dangthanhson2kk4-dotcom/Openlane_SERV_OPT/runs/Routing/reports/routing/23-wire_lengths.csv

net | length_um
_0539_ | 359.16
clknet_0_clk | 308.57
_0515_ | 307.67
_0203_ | 288.87
_0189_ | 285.43
net72 | 272.05
_0579_ | 256.38
_0590_ | 253.63
_0252_ | 248.465
_0572_ | 247.97
net79 | 245.08
net136 | 241.63
net116 | 236.48
net93 | 234.32
_0448_ | 221.24
net112 | 221.14
_0453_ | 218.17
net141 | 211.04
net148 | 209.22
net105 | 206.74
net91 | 206.14
net83 | 199.21
net122 | 198.1
net159 | 192.8
_0420_ | 190.28
_0397_ | 189.08
net34 | 188.5
net166 | 185.37
net107 | 183.365
net157 | 183.14
net89 | 179.84
net67 | 173.42
net119 | 170.88
net75 | 167.38
net149 | 167.38
clk | 165
net146 | 164.46
_0522_ | 163.71
net164 | 161.2
net22 | 159.63
net98 | 159.32
_0342_ | 157.62
clknet_4_0_0_clk | 157.44
_0461_ | 157.02
_0417_ | 155.8
net19 | 154.64
rf_ram_if.rtrig0 | 154.63
_0211_ | 153.86
net43 | 153.18
clknet_4_7_0_clk | 152.7
clknet_4_2_0_clk | 150.66
net82 | 150.2
net46 | 149.65
cpu.bufreg.data\[0\] | 148.375
net69 | 147.65
net6 | 142.89
net155 | 142.82
net108 | 142.62
_0614_ | 141.9
net115 | 141.69
net88 | 140.88
net86 | 140.78
_0314_ | 140.12
net5 | 137.9
_0324_ | 137.82
net117 | 135.86
net21 | 135.26
_0419_ | 134.44
clknet_4_15_0_clk | 133.54
net42 | 133.29
net144 | 132.54
net178 | 131.86
_0415_ | 131.49
net4 | 130.58
net127 | 130.56
net30 | 130.54
net129 | 129.98
_0290_ | 129.54
net12 | 129.42
net126 | 129.42
net145 | 129.36
_0276_ | 128.87
_0610_ | 128.87
cpu.alu.i_rs1 | 128.57
net137 | 127.54
net37 | 126.66
net96 | 126.1
clknet_4_4_0_clk | 126.06
net140 | 125.82
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
_0421_ | 1.26
_0454_ | 1.26
_0184_ | 1.14
_0191_ | 1.14
_0215_ | 1.14
_0240_ | 1.14
_0245_ | 1.14
_0287_ | 1.14
_0334_ | 1.14
_0532_ | 1.14
_0533_ | 1.14
_0542_ | 1.14
_0545_ | 1.14
_0546_ | 1.14
_0549_ | 1.14
_0620_ | 1.14
_0631_ | 1.14
cpu.mem_if.signbit | 1.14
_0319_ | 0.92
_0518_ | 0.92
