dangthanhson2kk4-dotcom/Openlane_SERV_OPT/runs/Routing/results/signoff/serv_synth_wrapper.spice

* NGSPICE file created from serv_synth_wrapper.ext - technology: sky130A

* Black-box entry subcircuit for sky130_fd_sc_hd__tapvpwrvgnd_1 abstract view
.subckt sky130_fd_sc_hd__tapvpwrvgnd_1 VGND VPWR
.ends

* Black-box entry subcircuit for sky130_fd_sc_hd__fill_2 abstract view
.subckt sky130_fd_sc_hd__fill_2 VGND VNB VPB VPWR
.ends

* Black-box entry subcircuit for sky130_fd_sc_hd__decap_3 abstract view
.subckt sky130_fd_sc_hd__decap_3 VGND VNB VPB VPWR
.ends

* Black-box entry subcircuit for sky130_fd_sc_hd__decap_4 abstract view
.subckt sky130_fd_sc_hd__decap_4 VGND VNB VPB VPWR
.ends

* Black-box entry subcircuit for sky130_fd_sc_hd__fill_1 abstract view
.subckt sky130_fd_sc_hd__fill_1 VGND VNB VPB VPWR
.ends

* Black-box entry subcircuit for sky130_ef_sc_hd__decap_12 abstract view
.subckt sky130_ef_sc_hd__decap_12 VPWR VGND VPB VNB
.ends

* Black-box entry subcircuit for sky130_fd_sc_hd__mux2_1 abstract view
.subckt sky130_fd_sc_hd__mux2_1 A0 A1 S VGND VNB VPB VPWR X
.ends

* Black-box entry subcircuit for sky130_fd_sc_hd__a22o_1 abstract view
.subckt sky130_fd_sc_hd__a22o_1 A1 A2 B1 B2 VGND VNB VPB VPWR X
.ends

* Black-box entry subcircuit for sky130_fd_sc_hd__dfxtp_1 abstract view
.subckt sky130_fd_sc_hd__dfxtp_1 CLK D VGND VNB VPB VPWR Q
.ends

* Black-box entry subcircuit for sky130_fd_sc_hd__nor2_1 abstract view
.subckt sky130_fd_sc_hd__nor2_1 A B VGND VNB VPB VPWR Y
.ends

* Black-box entry subcircuit for sky130_fd_sc_hd__clkbuf_1 abstract view
.subckt sky130_fd_sc_hd__clkbuf_1 A VGND VNB VPB VPWR X
.ends

* Black-box entry subcircuit for sky130_fd_sc_hd__clkbuf_8 abstract view
.subckt sky130_fd_sc_hd__clkbuf_8 A VGND VNB VPB VPWR X
.ends

* Black-box entry subcircuit for sky130_fd_sc_hd__o21a_2 abstract view
.subckt sky130_fd_sc_hd__o21a_2 A1 A2 B1 VGND VNB VPB VPWR X
.ends

* Black-box entry subcircuit for sky130_fd_sc_hd__decap_6 abstract view
.subckt sky130_fd_sc_hd__decap_6 VGND VNB VPB VPWR
.ends

* Black-box entry subcircuit for sky130_fd_sc_hd__a21o_1 abstract view
.subckt sky130_fd_sc_hd__a21o_1 A1 A2 B1 VGND VNB VPB VPWR X
.ends

* Black-box entry subcircuit for sky130_fd_sc_hd__a31o_1 abstract view
.subckt sky130_fd_sc_hd__a31o_1 A1 A2 A3 B1 VGND VNB VPB VPWR X
.ends

* Black-box entry subcircuit for sky130_fd_sc_hd__a31oi_1 abstract view
.subckt sky130_fd_sc_hd__a31oi_1 A1 A2 A3 B1 VGND VNB VPB VPWR Y
.ends

* Black-box entry subcircuit for sky130_fd_sc_hd__a211oi_1 abstract view
.subckt sky130_fd_sc_hd__a211oi_1 A1 A2 B1 C1 VGND VNB VPB VPWR Y
.ends

* Black-box entry subcircuit for sky130_fd_sc_hd__or4_1 abstract view
.subckt sky130_fd_sc_hd__or4_1 A B C D VGND VNB VPB VPWR X
.ends

* Black-box entry subcircuit for sky130_fd_sc_hd__clkbuf_4 abstract view
.subckt sky130_fd_sc_hd__clkbuf_4 A VGND VNB VPB VPWR X
.ends

* Black-box entry subcircuit for sky130_fd_sc_hd__buf_2 abstract view
.subckt sky130_fd_sc_hd__buf_2 A VGND VNB VPB VPWR X
.ends

* Black-box entry subcircuit for sky130_fd_sc_hd__and2b_1 abstract view
.subckt sky130_fd_sc_hd__and2b_1 A_N B VGND VNB VPB VPWR X
.ends

* Black-box entry subcircuit for sky130_fd_sc_hd__nor3_1 abstract view
.subckt sky130_fd_sc_hd__nor3_1 A B C VGND VNB VPB VPWR Y
.ends

* Black-box entry subcircuit for sky130_fd_sc_hd__or2_1 abstract view
.subckt sky130_fd_sc_hd__or2_1 A B VGND VNB VPB VPWR X
.ends

* Black-box entry subcircuit for sky130_fd_sc_hd__xnor2_1 abstract view
.subckt sky130_fd_sc_hd__xnor2_1 A B VGND VNB VPB VPWR Y
.ends

* Black-box entry subcircuit for sky130_fd_sc_hd__o311a_1 abstract view
.subckt sky130_fd_sc_hd__o311a_1 A1 A2 A3 B1 C1 VGND VNB VPB VPWR X
.ends

* Black-box entry subcircuit for sky130_fd_sc_hd__decap_8 abstract view
.subckt sky130_fd_sc_hd__decap_8 VGND VNB VPB VPWR
.ends

* Black-box entry subcircuit for sky130_fd_sc_hd__clkbuf_2 abstract view
.subckt sky130_fd_sc_hd__clkbuf_2 A VGND VNB VPB VPWR X
.ends

* Black-box entry subcircuit for sky130_fd_sc_hd__dfxtp_2 abstract view
.subckt sky130_fd_sc_hd__dfxtp_2 CLK D VGND VNB VPB VPWR Q
.ends

* Black-box entry subcircuit for sky130_fd_sc_hd__a21oi_1 abstract view
.subckt sky130_fd_sc_hd__a21oi_1 A1 A2 B1 VGND VNB VPB VPWR Y
.ends

* Black-box entry subcircuit for sky130_fd_sc_hd__o21a_1 abstract view
.subckt sky130_fd_sc_hd__o21a_1 A1 A2 B1 VGND VNB VPB VPWR X
.ends

* Black-box entry subcircuit for sky130_fd_sc_hd__or3_1 abstract view
.subckt sky130_fd_sc_hd__or3_1 A B C VGND VNB VPB VPWR X
.ends

* Black-box entry subcircuit for sky130_fd_sc_hd__buf_4 abstract view
.subckt sky130_fd_sc_hd__buf_4 A VGND VNB VPB VPWR X
.ends

* Black-box entry subcircuit for sky130_fd_sc_hd__inv_2 abstract view
.subckt sky130_fd_sc_hd__inv_2 A VGND VNB VPB VPWR Y
.ends

* Black-box entry subcircuit for sky130_fd_sc_hd__nor2_2 abstract view
.subckt sky130_fd_sc_hd__nor2_2 A B VGND VNB VPB VPWR Y
.ends

* Black-box entry subcircuit for sky130_fd_sc_hd__dlygate4sd3_1 abstract view
.subckt sky130_fd_sc_hd__dlygate4sd3_1 A VGND VNB VPB VPWR X
.ends

* Black-box entry subcircuit for sky130_fd_sc_hd__nor2_4 abstract view
.subckt sky130_fd_sc_hd__nor2_4 A B VGND VNB VPB VPWR Y
.ends

* Black-box entry subcircuit for sky130_fd_sc_hd__nand2_1 abstract view
.subckt sky130_fd_sc_hd__nand2_1 A B VGND VNB VPB VPWR Y
.ends

* Black-box entry subcircuit for sky130_fd_sc_hd__and3_1 abstract view
.subckt sky130_fd_sc_hd__and3_1 A B C VGND VNB VPB VPWR X
.ends

* Black-box entry subcircuit for sky130_fd_sc_hd__conb_1 abstract view
.subckt sky130_fd_sc_hd__conb_1 VGND VNB VPB VPWR HI LO
.ends

* Black-box entry subcircuit for sky130_fd_sc_hd__a21o_2 abstract view
.subckt sky130_fd_sc_hd__a21o_2 A1 A2 B1 VGND VNB VPB VPWR X
.ends

* Black-box entry subcircuit for sky130_fd_sc_hd__a41o_1 abstract view
.subckt sky130_fd_sc_hd__a41o_1 A1 A2 A3 A4 B1 VGND VNB VPB VPWR X
.ends

* Black-box entry subcircuit for sky130_fd_sc_hd__o31a_1 abstract view
.subckt sky130_fd_sc_hd__o31a_1 A1 A2 A3 B1 VGND VNB VPB VPWR X
.ends

* Black-box entry subcircuit for sky130_fd_sc_hd__a221o_1 abstract view
.subckt sky130_fd_sc_hd__a221o_1 A1 A2 B1 B2 C1 VGND VNB VPB VPWR X
.ends

* Black-box entry subcircuit for sky130_fd_sc_hd__a211o_1 abstract view
.subckt sky130_fd_sc_hd__a211o_1 A1 A2 B1 C1 VGND VNB VPB VPWR X
.ends

* Black-box entry subcircuit for sky130_fd_sc_hd__nand4_1 abstract view
.subckt sky130_fd_sc_hd__nand4_1 A B C D VGND VNB VPB VPWR Y
.ends

* Black-box entry subcircuit for sky130_fd_sc_hd__o211a_1 abstract view
.subckt sky130_fd_sc_hd__o211a_1 A1 A2 B1 C1 VGND VNB VPB VPWR X
.ends

* Black-box entry subcircuit for sky130_fd_sc_hd__o221a_1 abstract view
.subckt sky130_fd_sc_hd__o221a_1 A1 A2 B1 B2 C1 VGND VNB VPB VPWR X
.ends

* Black-box entry subcircuit for sky130_fd_sc_hd__a21oi_4 abstract view
.subckt sky130_fd_sc_hd__a21oi_4 A1 A2 B1 VGND VNB VPB VPWR Y
.ends

* Black-box entry subcircuit for sky130_fd_sc_hd__nor3b_1 abstract view
.subckt sky130_fd_sc_hd__nor3b_1 A B C_N VGND VNB VPB VPWR Y
.ends

* Black-box entry subcircuit for sky130_fd_sc_hd__clkbuf_16 abstract view
.subckt sky130_fd_sc_hd__clkbuf_16 A VGND VNB VPB VPWR X
.ends

* Black-box entry subcircuit for sky130_fd_sc_hd__o21ba_1 abstract view
.subckt sky130_fd_sc_hd__o21ba_1 A1 A2 B1_N VGND VNB VPB VPWR X
.ends

* Black-box entry subcircuit for sky130_fd_sc_hd__and3b_1 abstract view
.subckt sky130_fd_sc_hd__and3b_1 A_N B C VGND VNB VPB VPWR X
.ends

* Black-box entry subcircuit for sky130_fd_sc_hd__and4_1 abstract view
.subckt sky130_fd_sc_hd__and4_1 A B C D VGND VNB VPB VPWR X
.ends

* Black-box entry subcircuit for sky130_fd_sc_hd__and2_1 abstract view
.subckt sky130_fd_sc_hd__and2_1 A B VGND VNB VPB VPWR X
.ends

* Black-box entry subcircuit for sky130_fd_sc_hd__o21ai_1 abstract view
.subckt sky130_fd_sc_hd__o21ai_1 A1 A2 B1 VGND VNB VPB VPWR Y
.ends

* Black-box entry subcircuit for sky130_fd_sc_hd__a211o_2 abstract view
.subckt sky130_fd_sc_hd__a211o_2 A1 A2 B1 C1 VGND VNB VPB VPWR X
.ends

* Black-box entry subcircuit for sky130_fd_sc_hd__a21boi_1 abstract view
.subckt sky130_fd_sc_hd__a21boi_1 A1 A2 B1_N VGND VNB VPB VPWR Y
.ends

* Black-box entry subcircuit for sky130_fd_sc_hd__nor4_1 abstract view
.subckt sky130_fd_sc_hd__nor4_1 A B C D VGND VNB VPB VPWR Y
.ends

* Black-box entry subcircuit for sky130_fd_sc_hd__o211ai_1 abstract view
.subckt sky130_fd_sc_hd__o211ai_1 A1 A2 B1 C1 VGND VNB VPB VPWR Y
.ends

* Black-box entry subcircuit for sky130_fd_sc_hd__o22a_1 abstract view
.subckt sky130_fd_sc_hd__o22a_1 A1 A2 B1 B2 VGND VNB VPB VPWR X
.ends

* Black-box entry subcircuit for sky130_fd_sc_hd__a32o_1 abstract view
.subckt sky130_fd_sc_hd__a32o_1 A1 A2 A3 B1 B2 VGND VNB VPB VPWR X
.ends

* Black-box entry subcircuit for sky130_fd_sc_hd__buf_1 abstract view
.subckt sky130_fd_sc_hd__buf_1 A VGND VNB VPB VPWR X
.ends

* Black-box entry subcircuit for sky130_fd_sc_hd__a21bo_1 abstract view
.subckt sky130_fd_sc_hd__a21bo_1 A1 A2 B1_N VGND VNB VPB VPWR X
.ends

* Black-box entry subcircuit for sky130_fd_sc_hd__mux2_2 abstract view
.subckt sky130_fd_sc_hd__mux2_2 A0 A1 S VGND VNB VPB VPWR X
.ends

* Black-box entry subcircuit for sky130_fd_sc_hd__mux4_1 abstract view
.subckt sky130_fd_sc_hd__mux4_1 A0 A1 A2 A3 S0 S1 VGND VNB VPB VPWR X
.ends

* Black-box entry subcircuit for sky130_fd_sc_hd__nand3_1 abstract view
.subckt sky130_fd_sc_hd__nand3_1 A B C VGND VNB VPB VPWR Y
.ends

* Black-box entry subcircuit for sky130_fd_sc_hd__or3b_1 abstract view
.subckt sky130_fd_sc_hd__or3b_1 A B C_N VGND VNB VPB VPWR X
.ends

* Black-box entry subcircuit for sky130_fd_sc_hd__a311o_1 abstract view
.subckt sky130_fd_sc_hd__a311o_1 A1 A2 A3 B1 C1 VGND VNB VPB VPWR X
.ends

* Black-box entry subcircuit for sky130_fd_sc_hd__dfxtp_4 abstract view
.subckt sky130_fd_sc_hd__dfxtp_4 CLK D VGND VNB VPB VPWR Q
.ends

* Black-box entry subcircuit for sky130_fd_sc_hd__o211a_2 abstract view
.subckt sky130_fd_sc_hd__o211a_2 A1 A2 B1 C1 VGND VNB VPB VPWR X
.ends

* Black-box entry subcircuit for sky130_fd_sc_hd__or4b_1 abstract view
.subckt sky130_fd_sc_hd__or4b_1 A B C D_N VGND VNB VPB VPWR X
.ends

* Black-box entry subcircuit for sky130_fd_sc_hd__dlymetal6s2s_1 abstract view
.subckt sky130_fd_sc_hd__dlymetal6s2s_1 A VGND VNB VPB VPWR X
.ends

* Black-box entry subcircuit for sky130_fd_sc_hd__a31o_4 abstract view
.subckt sky130_fd_sc_hd__a31o_4 A1 A2 A3 B1 VGND VNB VPB VPWR X
.ends

* Black-box entry subcircuit for sky130_fd_sc_hd__or2_2 abstract view
.subckt sky130_fd_sc_hd__or2_2 A B VGND VNB VPB VPWR X
.ends

* Black-box entry subcircuit for sky130_fd_sc_hd__or4_2 abstract view
.subckt sky130_fd_sc_hd__or4_2 A B C D VGND VNB VPB VPWR X
.ends

* Black-box entry subcircuit for sky130_fd_sc_hd__or2b_1 abstract view
.subckt sky130_fd_sc_hd__or2b_1 A B_N VGND VNB VPB VPWR X
.ends

* Black-box entry subcircuit for sky130_fd_sc_hd__xor2_1 abstract view
.subckt sky130_fd_sc_hd__xor2_1 A B VGND VNB VPB VPWR X
.ends

* Black-box entry subcircuit for sky130_fd_sc_hd__o2111ai_1 abstract view
.subckt sky130_fd_sc_hd__o2111ai_1 A1 A2 B1 C1 D1 VGND VNB VPB VPWR Y
.ends

* Black-box entry subcircuit for sky130_fd_sc_hd__o2bb2a_1 abstract view
.subckt sky130_fd_sc_hd__o2bb2a_1 A1_N A2_N B1 B2 VGND VNB VPB VPWR X
.ends

* Black-box entry subcircuit for sky130_fd_sc_hd__a2bb2o_1 abstract view
.subckt sky130_fd_sc_hd__a2bb2o_1 A1_N A2_N B1 B2 VGND VNB VPB VPWR X
.ends

* Black-box entry subcircuit for sky130_fd_sc_hd__o2111a_1 abstract view
.subckt sky130_fd_sc_hd__o2111a_1 A1 A2 B1 C1 D1 VGND VNB VPB VPWR X
.ends

* Black-box entry subcircuit for sky130_fd_sc_hd__o32a_1 abstract view
.subckt sky130_fd_sc_hd__o32a_1 A1 A2 A3 B1 B2 VGND VNB VPB VPWR X
.ends

* Black-box entry subcircuit for sky130_fd_sc_hd__and2_2 abstract view
.subckt sky130_fd_sc_hd__and2_2 A B VGND VNB VPB VPWR X
.ends

* Black-box entry subcircuit for sky130_fd_sc_hd__nand2_4 abstract view
.subckt sky130_fd_sc_hd__nand2_4 A B VGND VNB VPB VPWR Y
.ends

* Black-box entry subcircuit for sky130_fd_sc_hd__diode_2 abstract view
.subckt sky130_fd_sc_hd__diode_2 DIODE VGND VNB VPB VPWR
.ends

* Black-box entry subcircuit for sky130_fd_sc_hd__nor3_2 abstract view
.subckt sky130_fd_sc_hd__nor3_2 A B C VGND VNB VPB VPWR Y
.ends

* Black-box entry subcircuit for sky130_fd_sc_hd__o21ai_2 abstract view
.subckt sky130_fd_sc_hd__o21ai_2 A1 A2 B1 VGND VNB VPB VPWR Y
.ends

.subckt serv_synth_wrapper VGND VPWR clk i_dbus_ack i_dbus_rdt[0] i_dbus_rdt[10] i_dbus_rdt[11]
+ i_dbus_rdt[12] i_dbus_rdt[13] i_dbus_rdt[14] i_dbus_rdt[15] i_dbus_rdt[16] i_dbus_rdt[17]
+ i_dbus_rdt[18] i_dbus_rdt[19] i_dbus_rdt[1] i_dbus_rdt[20] i_dbus_rdt[21] i_dbus_rdt[22]
+ i_dbus_rdt[23] i_dbus_rdt[24] i_dbus_rdt[25] i_dbus_rdt[26] i_dbus_rdt[27] i_dbus_rdt[28]
+ i_dbus_rdt[29] i_dbus_rdt[2] i_dbus_rdt[30] i_dbus_rdt[31] i_dbus_rdt[3] i_dbus_rdt[4]
+ i_dbus_rdt[5] i_dbus_rdt[6] i_dbus_rdt[7] i_dbus_rdt[8] i_dbus_rdt[9] i_ibus_ack
+ i_ibus_rdt[0] i_ibus_rdt[10] i_ibus_rdt[11] i_ibus_rdt[12] i_ibus_rdt[13] i_ibus_rdt[14]
+ i_ibus_rdt[15] i_ibus_rdt[16] i_ibus_rdt[17] i_ibus_rdt[18] i_ibus_rdt[19] i_ibus_rdt[1]
+ i_ibus_rdt[20] i_ibus_rdt[21] i_ibus_rdt[22] i_ibus_rdt[23] i_ibus_rdt[24] i_ibus_rdt[25]
+ i_ibus_rdt[26] i_ibus_rdt[27] i_ibus_rdt[28] i_ibus_rdt[29] i_ibus_rdt[2] i_ibus_rdt[30]
+ i_ibus_rdt[31] i_ibus_rdt[3] i_ibus_rdt[4] i_ibus_rdt[5] i_ibus_rdt[6] i_ibus_rdt[7]
+ i_ibus_rdt[8] i_ibus_rdt[9] i_rdata[0] i_rdata[1] i_rst i_timer_irq o_dbus_adr[0]
+ o_dbus_adr[10] o_dbus_adr[11] o_dbus_adr[12] o_dbus_adr[13] o_dbus_adr[14] o_dbus_adr[15]
+ o_dbus_adr[16] o_dbus_adr[17] o_dbus_adr[18] o_dbus_adr[19] o_dbus_adr[1] o_dbus_adr[20]
+ o_dbus_adr[21] o_dbus_adr[22] o_dbus_adr[23] o_dbus_adr[24] o_dbus_adr[25] o_dbus_adr[26]
+ o_dbus_adr[27] o_dbus_adr[28] o_dbus_adr[29] o_dbus_adr[2] o_dbus_adr[30] o_dbus_adr[31]
+ o_dbus_adr[3] o_dbus_adr[4] o_dbus_adr[5] o_dbus_adr[6] o_dbus_adr[7] o_dbus_adr[8]
+ o_dbus_adr[9] o_dbus_cyc o_dbus_dat[0] o_dbus_dat[10] o_dbus_dat[11] o_dbus_dat[12]
+ o_dbus_dat[13] o_dbus_dat[14] o_dbus_dat[15] o_dbus_dat[16] o_dbus_dat[17] o_dbus_dat[18]
+ o_dbus_dat[19] o_dbus_dat[1] o_dbus_dat[20] o_dbus_dat[21] o_dbus_dat[22] o_dbus_dat[23]
+ o_dbus_dat[24] o_dbus_dat[25] o_dbus_dat[26] o_dbus_dat[27] o_dbus_dat[28] o_dbus_dat[29]
+ o_dbus_dat[2] o_dbus_dat[30] o_dbus_dat[31] o_dbus_dat[3] o_dbus_dat[4] o_dbus_dat[5]
+ o_dbus_dat[6] o_dbus_dat[7] o_dbus_dat[8] o_dbus_dat[9] o_dbus_sel[0] o_dbus_sel[1]
+ o_dbus_sel[2] o_dbus_sel[3] o_dbus_we o_ibus_adr[0] o_ibus_adr[10] o_ibus_adr[11]
+ o_ibus_adr[12] o_ibus_adr[13] o_ibus_adr[14] o_ibus_adr[15] o_ibus_adr[16] o_ibus_adr[17]
+ o_ibus_adr[18] o_ibus_adr[19] o_ibus_adr[1] o_ibus_adr[20] o_ibus_adr[21] o_ibus_adr[22]
+ o_ibus_adr[23] o_ibus_adr[24] o_ibus_adr[25] o_ibus_adr[26] o_ibus_adr[27] o_ibus_adr[28]
+ o_ibus_adr[29] o_ibus_adr[2] o_ibus_adr[30] o_ibus_adr[31] o_ibus_adr[3] o_ibus_adr[4]
+ o_ibus_adr[5] o_ibus_adr[6] o_ibus_adr[7] o_ibus_adr[8] o_ibus_adr[9] o_ibus_cyc
+ o_raddr[0] o_raddr[1] o_raddr[2] o_raddr[3] o_raddr[4] o_raddr[5] o_raddr[6] o_raddr[7]
+ o_raddr[8] o_raddr[9] o_waddr[0] o_waddr[1] o_waddr[2] o_waddr[3] o_waddr[4] o_waddr[5]
+ o_waddr[6] o_waddr[7] o_waddr[8] o_waddr[9] o_wdata[0] o_wdata[1] o_wen
XTAP_177 VGND VPWR sky130_fd_sc_hd__tapvpwrvgnd_1
XTAP_188 VGND VPWR sky130_fd_sc_hd__tapvpwrvgnd_1
XTAP_199 VGND VPWR sky130_fd_sc_hd__tapvpwrvgnd_1
XFILLER_0_17_222 VGND VGND VPWR VPWR sky130_fd_sc_hd__fill_2
XFILLER_0_17_233 VGND VGND VPWR VPWR sky130_fd_sc_hd__decap_3
XFILLER_0_17_255 VGND VGND VPWR VPWR sky130_fd_sc_hd__decap_4
XFILLER_0_32_203 VGND VGND VPWR VPWR sky130_fd_sc_hd__fill_1
XFILLER_0_17_277 VGND VGND VPWR VPWR sky130_fd_sc_hd__decap_3
XFILLER_0_23_225 VPWR VGND VPWR VGND sky130_ef_sc_hd__decap_12
XFILLER_0_48_26 VGND VGND VPWR VPWR sky130_fd_sc_hd__fill_2
X_1270_ net102 net103 _0211_ VGND VGND VPWR VPWR _0214_ sky130_fd_sc_hd__mux2_1
XFILLER_0_13_51 VGND VGND VPWR VPWR sky130_fd_sc_hd__decap_4
X_0985_ net137 _0520_ _0523_ net148 VGND VGND VPWR VPWR _0034_ sky130_fd_sc_hd__a22o_1
XFILLER_0_1_141 VPWR VGND VPWR VGND sky130_ef_sc_hd__decap_12
XFILLER_0_14_203 VGND VGND VPWR VPWR sky130_fd_sc_hd__fill_1
X_1468_ clknet_4_12_0_clk _0130_ VGND VGND VPWR VPWR cpu.decode.op21 sky130_fd_sc_hd__dfxtp_1
X_1399_ clknet_4_14_0_clk _0064_ VGND VGND VPWR VPWR net160 sky130_fd_sc_hd__dfxtp_1
XFILLER_0_1_196 VPWR VGND VPWR VGND sky130_ef_sc_hd__decap_12
XFILLER_0_18_29 VGND VGND VPWR VPWR sky130_fd_sc_hd__fill_1
XFILLER_0_50_27 VGND VGND VPWR VPWR sky130_fd_sc_hd__fill_1
X_0770_ net137 cpu.ctrl.pc_plus_4_cy_r VGND VGND VPWR VPWR _0352_ sky130_fd_sc_hd__nor2_1
X_1322_ _0246_ VGND VGND VPWR VPWR _0170_ sky130_fd_sc_hd__clkbuf_1
X_1253_ net128 net129 _0189_ VGND VGND VPWR VPWR _0202_ sky130_fd_sc_hd__mux2_1
X_1184_ cpu.immdec.gen_immdec_w_eq_1.imm30_25\[1\] _0638_ _0636_ VGND VGND VPWR VPWR
+ _0639_ sky130_fd_sc_hd__mux2_1
XFILLER_0_24_50 VPWR VGND VPWR VGND sky130_ef_sc_hd__decap_12
Xclkbuf_4_12_0_clk clknet_0_clk VGND VGND VPWR VPWR clknet_4_12_0_clk sky130_fd_sc_hd__clkbuf_8
XFILLER_0_34_309 VGND VGND VPWR VPWR sky130_fd_sc_hd__fill_2
X_0968_ net193 _0457_ _0447_ VGND VGND VPWR VPWR _0512_ sky130_fd_sc_hd__o21a_2
XFILLER_0_6_277 VPWR VGND VPWR VGND sky130_ef_sc_hd__decap_12
X_0899_ _0460_ VGND VGND VPWR VPWR _0011_ sky130_fd_sc_hd__clkbuf_1
XFILLER_0_37_169 VGND VGND VPWR VPWR sky130_fd_sc_hd__decap_4
XFILLER_0_25_309 VGND VGND VPWR VPWR sky130_fd_sc_hd__fill_1
XFILLER_0_45_27 VGND VGND VPWR VPWR sky130_fd_sc_hd__fill_1
XFILLER_0_9_49 VGND VGND VPWR VPWR sky130_fd_sc_hd__decap_6
X_0822_ cpu.bufreg.data\[1\] _0399_ _0298_ VGND VGND VPWR VPWR net135 sky130_fd_sc_hd__a21o_1
X_0684_ _0276_ cpu.immdec.gen_immdec_w_eq_1.imm24_20\[2\] _0269_ _0277_ VGND VGND
+ VPWR VPWR net176 sky130_fd_sc_hd__a31o_1
X_0753_ cpu.bufreg.data\[0\] _0324_ _0326_ _0334_ VGND VGND VPWR VPWR _0335_ sky130_fd_sc_hd__a31oi_1
XFILLER_0_3_225 VPWR VGND VPWR VGND sky130_ef_sc_hd__decap_12
XFILLER_0_10_74 VGND VGND VPWR VPWR sky130_fd_sc_hd__fill_1
X_1305_ _0237_ VGND VGND VPWR VPWR _0162_ sky130_fd_sc_hd__clkbuf_1
X_1236_ _0190_ net2 _0579_ VGND VGND VPWR VPWR _0191_ sky130_fd_sc_hd__mux2_1
X_1167_ _0625_ cpu.immdec.gen_immdec_w_eq_1.imm19_12_20\[7\] _0610_ VGND VGND VPWR
+ VPWR _0626_ sky130_fd_sc_hd__mux2_1
X_1098_ net116 _0568_ _0574_ VGND VGND VPWR VPWR _0575_ sky130_fd_sc_hd__mux2_1
XFILLER_0_51_81 VPWR VGND VPWR VGND sky130_ef_sc_hd__decap_12
XFILLER_0_34_139 VGND VGND VPWR VPWR sky130_fd_sc_hd__fill_1
XFILLER_0_25_117 VGND VGND VPWR VPWR sky130_fd_sc_hd__fill_1
XFILLER_0_25_139 VGND VGND VPWR VPWR sky130_fd_sc_hd__fill_1
XFILLER_0_33_172 VPWR VGND VPWR VGND sky130_ef_sc_hd__decap_12
XFILLER_0_48_209 VGND VGND VPWR VPWR sky130_fd_sc_hd__fill_1
X_1021_ cpu.ctrl.i_jump _0340_ _0528_ _0268_ VGND VGND VPWR VPWR _0529_ sky130_fd_sc_hd__a211oi_1
XFILLER_0_12_301 VGND VGND VPWR VPWR sky130_fd_sc_hd__decap_6
XFILLER_0_21_73 VGND VGND VPWR VPWR sky130_fd_sc_hd__decap_3
X_0805_ cpu.bufreg.data\[0\] _0324_ _0386_ _0258_ VGND VGND VPWR VPWR _0387_ sky130_fd_sc_hd__a22o_1
X_0667_ cpu.decode.co_ebreak _0255_ _0262_ VGND VGND VPWR VPWR _0263_ sky130_fd_sc_hd__o21a_2
X_0736_ net123 _0303_ _0317_ VGND VGND VPWR VPWR _0318_ sky130_fd_sc_hd__mux2_1
X_1219_ _0181_ VGND VGND VPWR VPWR _0132_ sky130_fd_sc_hd__clkbuf_1
XFILLER_0_1_72 VGND VGND VPWR VPWR sky130_fd_sc_hd__decap_3
XFILLER_0_15_161 VGND VGND VPWR VPWR sky130_fd_sc_hd__decap_6
XFILLER_0_22_109 VGND VGND VPWR VPWR sky130_fd_sc_hd__fill_2
XFILLER_0_30_197 VPWR VGND VPWR VGND sky130_ef_sc_hd__decap_12
XFILLER_0_26_29 VPWR VGND VPWR VGND sky130_ef_sc_hd__decap_12
XFILLER_0_38_253 VGND VGND VPWR VPWR sky130_fd_sc_hd__decap_3
XFILLER_0_5_309 VGND VGND VPWR VPWR sky130_fd_sc_hd__fill_1
XTAP_348 VGND VPWR sky130_fd_sc_hd__tapvpwrvgnd_1
XTAP_337 VGND VPWR sky130_fd_sc_hd__tapvpwrvgnd_1
XTAP_326 VGND VPWR sky130_fd_sc_hd__tapvpwrvgnd_1
XTAP_315 VGND VPWR sky130_fd_sc_hd__tapvpwrvgnd_1
XTAP_304 VGND VPWR sky130_fd_sc_hd__tapvpwrvgnd_1
XFILLER_0_21_175 VPWR VGND VPWR VGND sky130_ef_sc_hd__decap_12
XTAP_359 VGND VPWR sky130_fd_sc_hd__tapvpwrvgnd_1
XFILLER_0_29_231 VGND VGND VPWR VPWR sky130_fd_sc_hd__fill_1
XFILLER_0_29_220 VGND VGND VPWR VPWR sky130_fd_sc_hd__decap_4
X_1004_ net145 _0524_ _0525_ net146 VGND VGND VPWR VPWR _0051_ sky130_fd_sc_hd__a22o_1
XFILLER_0_32_94 VGND VGND VPWR VPWR sky130_fd_sc_hd__decap_6
X_0719_ net118 net119 net116 net117 VGND VGND VPWR VPWR _0301_ sky130_fd_sc_hd__or4_1
XFILLER_0_12_197 VGND VGND VPWR VPWR sky130_fd_sc_hd__decap_6
XFILLER_0_35_201 VGND VGND VPWR VPWR sky130_fd_sc_hd__decap_3
Xoutput75 net75 VGND VGND VPWR VPWR o_dbus_adr[16] sky130_fd_sc_hd__clkbuf_4
Xoutput97 net97 VGND VGND VPWR VPWR o_dbus_adr[8] sky130_fd_sc_hd__clkbuf_4
Xoutput86 net86 VGND VGND VPWR VPWR o_dbus_adr[27] sky130_fd_sc_hd__buf_2
XFILLER_0_1_312 VGND VGND VPWR VPWR sky130_fd_sc_hd__fill_2
XTAP_145 VGND VPWR sky130_fd_sc_hd__tapvpwrvgnd_1
XTAP_134 VGND VPWR sky130_fd_sc_hd__tapvpwrvgnd_1
XTAP_123 VGND VPWR sky130_fd_sc_hd__tapvpwrvgnd_1
XTAP_112 VGND VPWR sky130_fd_sc_hd__tapvpwrvgnd_1
XTAP_156 VGND VPWR sky130_fd_sc_hd__tapvpwrvgnd_1
XTAP_167 VGND VPWR sky130_fd_sc_hd__tapvpwrvgnd_1
XTAP_178 VGND VPWR sky130_fd_sc_hd__tapvpwrvgnd_1
XTAP_189 VGND VPWR sky130_fd_sc_hd__tapvpwrvgnd_1
X_1484_ clknet_4_3_0_clk _0146_ VGND VGND VPWR VPWR net128 sky130_fd_sc_hd__dfxtp_1
XFILLER_0_17_212 VGND VGND VPWR VPWR sky130_fd_sc_hd__decap_6
XFILLER_0_17_245 VGND VGND VPWR VPWR sky130_fd_sc_hd__fill_1
XFILLER_0_23_19 VGND VGND VPWR VPWR sky130_fd_sc_hd__decap_4
XFILLER_0_23_237 VGND VGND VPWR VPWR sky130_fd_sc_hd__decap_4
XFILLER_0_3_18 VPWR VGND VPWR VGND sky130_ef_sc_hd__decap_12
X_0984_ _0522_ VGND VGND VPWR VPWR _0523_ sky130_fd_sc_hd__clkbuf_4
XFILLER_0_1_153 VPWR VGND VPWR VGND sky130_ef_sc_hd__decap_12
X_1467_ clknet_4_13_0_clk _0129_ VGND VGND VPWR VPWR cpu.decode.op22 sky130_fd_sc_hd__dfxtp_1
X_1398_ clknet_4_11_0_clk _0063_ VGND VGND VPWR VPWR net158 sky130_fd_sc_hd__dfxtp_1
XFILLER_0_9_220 VGND VGND VPWR VPWR sky130_fd_sc_hd__decap_4
XFILLER_0_34_29 VPWR VGND VPWR VGND sky130_ef_sc_hd__decap_12
X_1321_ net67 cpu.state.cnt_r\[0\] VGND VGND VPWR VPWR _0246_ sky130_fd_sc_hd__and2b_1
X_1252_ _0201_ VGND VGND VPWR VPWR _0145_ sky130_fd_sc_hd__clkbuf_1
X_1183_ cpu.immdec.gen_immdec_w_eq_1.imm30_25\[2\] net51 _0614_ VGND VGND VPWR VPWR
+ _0638_ sky130_fd_sc_hd__mux2_1
XFILLER_0_24_62 VGND VGND VPWR VPWR sky130_fd_sc_hd__decap_4
XFILLER_0_40_61 VPWR VGND VPWR VGND sky130_ef_sc_hd__decap_12
X_0967_ cpu.immdec.gen_immdec_w_eq_1.imm11_7\[1\] net62 _0419_ VGND VGND VPWR VPWR
+ _0511_ sky130_fd_sc_hd__mux2_1
XFILLER_0_6_289 VPWR VGND VPWR VGND sky130_ef_sc_hd__decap_12
XFILLER_0_49_81 VPWR VGND VPWR VGND sky130_ef_sc_hd__decap_12
X_0898_ rf_ram_if.wen0_r _0459_ _0252_ VGND VGND VPWR VPWR _0460_ sky130_fd_sc_hd__mux2_1
XFILLER_0_52_107 VGND VGND VPWR VPWR sky130_fd_sc_hd__decap_4
X_0752_ _0326_ _0331_ _0333_ VGND VGND VPWR VPWR _0334_ sky130_fd_sc_hd__nor3_1
X_0821_ cpu.bne_or_bge cpu.bufreg.data\[0\] VGND VGND VPWR VPWR _0399_ sky130_fd_sc_hd__or2_1
X_0683_ _0276_ cpu.immdec.gen_immdec_w_eq_1.imm19_12_20\[6\] VGND VGND VPWR VPWR _0277_
+ sky130_fd_sc_hd__and2b_1
XFILLER_0_3_237 VPWR VGND VPWR VGND sky130_ef_sc_hd__decap_12
X_1166_ cpu.immdec.gen_immdec_w_eq_1.imm19_12_20\[8\] net43 _0614_ VGND VGND VPWR
+ VPWR _0625_ sky130_fd_sc_hd__mux2_1
X_1304_ _0236_ net16 _0590_ VGND VGND VPWR VPWR _0237_ sky130_fd_sc_hd__mux2_1
X_1235_ net100 net111 _0189_ VGND VGND VPWR VPWR _0190_ sky130_fd_sc_hd__mux2_1
XFILLER_0_19_84 VGND VGND VPWR VPWR sky130_fd_sc_hd__fill_2
X_1097_ _0573_ VGND VGND VPWR VPWR _0574_ sky130_fd_sc_hd__buf_2
XFILLER_0_51_93 VGND VGND VPWR VPWR sky130_fd_sc_hd__fill_1
XFILLER_0_42_151 VGND VGND VPWR VPWR sky130_fd_sc_hd__fill_1
XFILLER_0_34_118 VGND VGND VPWR VPWR sky130_fd_sc_hd__fill_2
XFILLER_0_33_195 VGND VGND VPWR VPWR sky130_fd_sc_hd__decap_6
XFILLER_0_33_184 VGND VGND VPWR VPWR sky130_fd_sc_hd__decap_6
X_1020_ cpu.ctrl.i_jump _0356_ VGND VGND VPWR VPWR _0528_ sky130_fd_sc_hd__nor2_1
Xclkbuf_4_11_0_clk clknet_0_clk VGND VGND VPWR VPWR clknet_4_11_0_clk sky130_fd_sc_hd__clkbuf_8
XFILLER_0_8_307 VGND VGND VPWR VPWR sky130_fd_sc_hd__fill_1
X_0804_ _0381_ _0385_ VGND VGND VPWR VPWR _0386_ sky130_fd_sc_hd__xnor2_1
X_0735_ _0304_ _0308_ _0315_ _0316_ cpu.decode.opcode\[2\] VGND VGND VPWR VPWR _0317_
+ sky130_fd_sc_hd__o311a_1
XFILLER_0_24_184 VPWR VGND VPWR VGND sky130_ef_sc_hd__decap_12
X_0666_ _0258_ _0261_ VGND VGND VPWR VPWR _0262_ sky130_fd_sc_hd__and2b_1
X_1149_ _0613_ VGND VGND VPWR VPWR _0108_ sky130_fd_sc_hd__clkbuf_1
X_1218_ cpu.bne_or_bge net37 _0420_ VGND VGND VPWR VPWR _0181_ sky130_fd_sc_hd__mux2_1
XFILLER_0_1_95 VPWR VGND VPWR VGND sky130_ef_sc_hd__decap_12
XFILLER_0_15_173 VPWR VGND VPWR VGND sky130_ef_sc_hd__decap_12
XFILLER_0_42_18 VGND VGND VPWR VPWR sky130_fd_sc_hd__decap_6
XFILLER_0_38_265 VPWR VGND VPWR VGND sky130_ef_sc_hd__decap_12
XFILLER_0_38_243 VGND VGND VPWR VPWR sky130_fd_sc_hd__decap_8
XTAP_349 VGND VPWR sky130_fd_sc_hd__tapvpwrvgnd_1
XTAP_338 VGND VPWR sky130_fd_sc_hd__tapvpwrvgnd_1
XTAP_327 VGND VPWR sky130_fd_sc_hd__tapvpwrvgnd_1
XTAP_316 VGND VPWR sky130_fd_sc_hd__tapvpwrvgnd_1
XTAP_305 VGND VPWR sky130_fd_sc_hd__tapvpwrvgnd_1
XFILLER_0_6_29 VGND VGND VPWR VPWR sky130_fd_sc_hd__fill_1
XFILLER_0_21_187 VGND VGND VPWR VPWR sky130_fd_sc_hd__decap_6
X_1003_ net144 _0524_ _0525_ net145 VGND VGND VPWR VPWR _0050_ sky130_fd_sc_hd__a22o_1
XFILLER_0_16_52 VGND VGND VPWR VPWR sky130_fd_sc_hd__fill_1
XFILLER_0_16_85 VGND VGND VPWR VPWR sky130_fd_sc_hd__decap_4
XFILLER_0_44_246 VGND VGND VPWR VPWR sky130_fd_sc_hd__decap_3
XFILLER_0_32_51 VGND VGND VPWR VPWR sky130_fd_sc_hd__decap_6
X_0718_ cpu.bufreg.i_right_shift_op VGND VGND VPWR VPWR _0300_ sky130_fd_sc_hd__clkbuf_4
XFILLER_0_35_268 VPWR VGND VPWR VGND sky130_ef_sc_hd__decap_12
Xoutput76 net76 VGND VGND VPWR VPWR o_dbus_adr[17] sky130_fd_sc_hd__buf_2
Xoutput87 net87 VGND VGND VPWR VPWR o_dbus_adr[28] sky130_fd_sc_hd__clkbuf_4
Xoutput98 net98 VGND VGND VPWR VPWR o_dbus_adr[9] sky130_fd_sc_hd__clkbuf_4
XFILLER_0_41_205 VGND VGND VPWR VPWR sky130_fd_sc_hd__decap_3
XFILLER_0_5_129 VGND VGND VPWR VPWR sky130_fd_sc_hd__fill_1
XTAP_135 VGND VPWR sky130_fd_sc_hd__tapvpwrvgnd_1
XTAP_124 VGND VPWR sky130_fd_sc_hd__tapvpwrvgnd_1
XTAP_113 VGND VPWR sky130_fd_sc_hd__tapvpwrvgnd_1
XTAP_146 VGND VPWR sky130_fd_sc_hd__tapvpwrvgnd_1
XTAP_157 VGND VPWR sky130_fd_sc_hd__tapvpwrvgnd_1
XTAP_168 VGND VPWR sky130_fd_sc_hd__tapvpwrvgnd_1
X_1483_ clknet_4_2_0_clk _0145_ VGND VGND VPWR VPWR net127 sky130_fd_sc_hd__dfxtp_1
XTAP_179 VGND VPWR sky130_fd_sc_hd__tapvpwrvgnd_1
XFILLER_0_27_73 VPWR VGND VPWR VGND sky130_ef_sc_hd__decap_12
XFILLER_0_17_202 VGND VGND VPWR VPWR sky130_fd_sc_hd__fill_2
X_0983_ _0521_ VGND VGND VPWR VPWR _0522_ sky130_fd_sc_hd__clkbuf_2
XFILLER_0_13_64 VPWR VGND VPWR VGND sky130_ef_sc_hd__decap_12
XFILLER_0_1_165 VGND VGND VPWR VPWR sky130_fd_sc_hd__decap_3
XFILLER_0_14_249 VGND VGND VPWR VPWR sky130_fd_sc_hd__decap_3
XFILLER_0_38_72 VPWR VGND VPWR VGND sky130_ef_sc_hd__decap_12
X_1466_ clknet_4_8_0_clk _0128_ VGND VGND VPWR VPWR cpu.decode.op26 sky130_fd_sc_hd__dfxtp_1
X_1397_ clknet_4_10_0_clk _0062_ VGND VGND VPWR VPWR net157 sky130_fd_sc_hd__dfxtp_2
XFILLER_0_49_113 VPWR VGND VPWR VGND sky130_ef_sc_hd__decap_12
XFILLER_0_34_19 VGND VGND VPWR VPWR sky130_fd_sc_hd__decap_8
XFILLER_0_51_300 VGND VGND VPWR VPWR sky130_fd_sc_hd__fill_2
XFILLER_0_50_29 VPWR VGND VPWR VGND sky130_ef_sc_hd__decap_12
X_1320_ _0444_ _0245_ _0415_ VGND VGND VPWR VPWR _0169_ sky130_fd_sc_hd__a21oi_1
XFILLER_0_11_219 VGND VGND VPWR VPWR sky130_fd_sc_hd__fill_1
X_1251_ _0200_ net29 _0579_ VGND VGND VPWR VPWR _0201_ sky130_fd_sc_hd__mux2_1
X_1182_ _0637_ VGND VGND VPWR VPWR _0117_ sky130_fd_sc_hd__clkbuf_1
XFILLER_0_40_73 VGND VGND VPWR VPWR sky130_fd_sc_hd__decap_8
XFILLER_0_40_40 VGND VGND VPWR VPWR sky130_fd_sc_hd__decap_6
X_0966_ _0510_ VGND VGND VPWR VPWR _0028_ sky130_fd_sc_hd__clkbuf_1
XFILLER_0_6_213 VPWR VGND VPWR VGND sky130_ef_sc_hd__decap_12
X_0897_ _0266_ _0458_ _0397_ VGND VGND VPWR VPWR _0459_ sky130_fd_sc_hd__o21a_1
X_1449_ clknet_4_13_0_clk _0111_ VGND VGND VPWR VPWR cpu.csr_imm sky130_fd_sc_hd__dfxtp_1
XFILLER_0_4_73 VGND VGND VPWR VPWR sky130_fd_sc_hd__fill_2
XFILLER_0_37_149 VGND VGND VPWR VPWR sky130_fd_sc_hd__decap_4
XFILLER_0_37_116 VPWR VGND VPWR VGND sky130_ef_sc_hd__decap_12
XFILLER_0_51_141 VPWR VGND VPWR VGND sky130_ef_sc_hd__decap_12
X_0751_ _0312_ _0332_ _0311_ VGND VGND VPWR VPWR _0333_ sky130_fd_sc_hd__a21oi_1
XFILLER_0_3_249 VPWR VGND VPWR VGND sky130_ef_sc_hd__decap_12
XFILLER_0_9_18 VGND VGND VPWR VPWR sky130_fd_sc_hd__decap_3
XFILLER_0_10_32 VGND VGND VPWR VPWR sky130_fd_sc_hd__fill_1
X_0820_ rf_ram_if.rtrig1 rf_ram_if.wen0_r rf_ram_if.wen1_r _0276_ VGND VGND VPWR VPWR
+ net192 sky130_fd_sc_hd__a22o_1
XFILLER_0_51_196 VPWR VGND VPWR VGND sky130_ef_sc_hd__decap_12
X_1303_ net114 net115 _0572_ VGND VGND VPWR VPWR _0236_ sky130_fd_sc_hd__mux2_1
X_0682_ rf_ram_if.rtrig0 VGND VGND VPWR VPWR _0276_ sky130_fd_sc_hd__buf_2
X_1165_ _0624_ VGND VGND VPWR VPWR _0113_ sky130_fd_sc_hd__clkbuf_1
X_1096_ _0567_ _0565_ _0572_ VGND VGND VPWR VPWR _0573_ sky130_fd_sc_hd__or3_1
X_1234_ _0572_ VGND VGND VPWR VPWR _0189_ sky130_fd_sc_hd__buf_4
XFILLER_0_42_141 VGND VGND VPWR VPWR sky130_fd_sc_hd__fill_1
X_0949_ _0498_ VGND VGND VPWR VPWR _0023_ sky130_fd_sc_hd__clkbuf_1
XFILLER_0_0_219 VGND VGND VPWR VPWR sky130_fd_sc_hd__fill_1
XFILLER_0_21_20 VPWR VGND VPWR VGND sky130_ef_sc_hd__decap_12
X_0734_ _0298_ VGND VGND VPWR VPWR _0316_ sky130_fd_sc_hd__inv_2
X_0803_ _0383_ _0384_ VGND VGND VPWR VPWR _0385_ sky130_fd_sc_hd__nor2_1
X_0665_ _0259_ _0260_ VGND VGND VPWR VPWR _0261_ sky130_fd_sc_hd__nor2_2
XFILLER_0_46_83 VGND VGND VPWR VPWR sky130_fd_sc_hd__fill_1
X_1148_ _0612_ cpu.immdec.gen_immdec_w_eq_1.imm19_12_20\[1\] _0610_ VGND VGND VPWR
+ VPWR _0613_ sky130_fd_sc_hd__mux2_1
X_1079_ _0559_ VGND VGND VPWR VPWR _0092_ sky130_fd_sc_hd__clkbuf_1
X_1217_ _0448_ cpu.decode.co_ebreak _0606_ VGND VGND VPWR VPWR _0131_ sky130_fd_sc_hd__a21o_1
XFILLER_0_30_122 VGND VGND VPWR VPWR sky130_fd_sc_hd__decap_6
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
