dangthanhson2kk4-dotcom/Openlane_SERV_OPT/runs/CTS/results/placement/serv_synth_wrapper.nl.v

module serv_synth_wrapper (clk,
    i_dbus_ack,
    i_ibus_ack,
    i_rst,
    i_timer_irq,
    o_dbus_cyc,
    o_dbus_we,
    o_ibus_cyc,
    o_wen,
    i_dbus_rdt,
    i_ibus_rdt,
    i_rdata,
    o_dbus_adr,
    o_dbus_dat,
    o_dbus_sel,
    o_ibus_adr,
    o_raddr,
    o_waddr,
    o_wdata);
 input clk;
 input i_dbus_ack;
 input i_ibus_ack;
 input i_rst;
 input i_timer_irq;
 output o_dbus_cyc;
 output o_dbus_we;
 output o_ibus_cyc;
 output o_wen;
 input [31:0] i_dbus_rdt;
 input [31:0] i_ibus_rdt;
 input [1:0] i_rdata;
 output [31:0] o_dbus_adr;
 output [31:0] o_dbus_dat;
 output [3:0] o_dbus_sel;
 output [31:0] o_ibus_adr;
 output [9:0] o_raddr;
 output [9:0] o_waddr;
 output [1:0] o_wdata;

 wire _0000_;
 wire _0001_;
 wire _0002_;
 wire _0003_;
 wire _0004_;
 wire _0005_;
 wire _0006_;
 wire _0007_;
 wire _0008_;
 wire _0009_;
 wire _0010_;
 wire _0011_;
 wire _0012_;
 wire _0013_;
 wire _0014_;
 wire _0015_;
 wire _0016_;
 wire _0017_;
 wire _0018_;
 wire _0019_;
 wire _0020_;
 wire _0021_;
 wire _0022_;
 wire _0023_;
 wire _0024_;
 wire _0025_;
 wire _0026_;
 wire _0027_;
 wire _0028_;
 wire _0029_;
 wire _0030_;
 wire _0031_;
 wire _0032_;
 wire _0033_;
 wire _0034_;
 wire _0035_;
 wire _0036_;
 wire _0037_;
 wire _0038_;
 wire _0039_;
 wire _0040_;
 wire _0041_;
 wire _0042_;
 wire _0043_;
 wire _0044_;
 wire _0045_;
 wire _0046_;
 wire _0047_;
 wire _0048_;
 wire _0049_;
 wire _0050_;
 wire _0051_;
 wire _0052_;
 wire _0053_;
 wire _0054_;
 wire _0055_;
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
 wire net135;
 wire net136;
 wire net137;
 wire net138;
 wire net139;
 wire net140;
 wire net141;
 wire net142;
 wire net143;
 wire net144;
 wire net145;
 wire net146;
 wire net147;
 wire net148;
 wire net149;
 wire net150;
 wire net151;
 wire net152;
 wire net153;
 wire net154;
 wire net155;
 wire net156;
 wire net157;
 wire net158;
 wire net159;
 wire net160;
 wire net161;
 wire net162;
 wire net163;
 wire net164;
 wire net165;
 wire net166;
 wire net167;
 wire net168;
 wire net169;
 wire net170;
 wire net171;
 wire net172;
 wire net173;
 wire net174;
 wire net175;
 wire net176;
 wire net177;
 wire net178;
 wire net179;
 wire net180;
 wire net181;
 wire net182;
 wire net183;
 wire net184;
 wire net185;
 wire net186;
 wire net187;
 wire net188;
 wire net189;
 wire net190;
 wire net191;
 wire net192;
 wire net193;
 wire net194;

 sky130_fd_sc_hd__inv_2 _0653_ (.A(net171),
    .Y(net181));
 sky130_fd_sc_hd__nor2_1 _0654_ (.A(\cpu.bufreg.data[1] ),
    .B(\cpu.bufreg.data[0] ),
    .Y(net132));
 sky130_fd_sc_hd__clkbuf_4 _0655_ (.A(\rf_ram_if.rtrig0 ),
    .X(_0252_));
 sky130_fd_sc_hd__mux2_1 _0656_ (.A0(\rf_ram_if.rdata0[1] ),
    .A1(net65),
    .S(_0252_),
    .X(_0253_));
 sky130_fd_sc_hd__clkbuf_1 _0657_ (.A(_0253_),
    .X(_0000_));
 sky130_fd_sc_hd__inv_2 _0658_ (.A(\cpu.decode.op21 ),
    .Y(_0254_));
 sky130_fd_sc_hd__and2_1 _0659_ (.A(_0254_),
    .B(\cpu.decode.op26 ),
    .X(_0255_));
 sky130_fd_sc_hd__inv_2 _0660_ (.A(_0255_),
    .Y(_0256_));
 sky130_fd_sc_hd__or2_1 _0661_ (.A(\cpu.bne_or_bge ),
    .B(\cpu.decode.co_mem_word ),
    .X(_0257_));
 sky130_fd_sc_hd__nor2_1 _0662_ (.A(\cpu.bufreg.i_right_shift_op ),
    .B(_0257_),
    .Y(_0258_));
 sky130_fd_sc_hd__inv_2 _0663_ (.A(\cpu.branch_op ),
    .Y(_0259_));
 sky130_fd_sc_hd__inv_2 _0664_ (.A(\cpu.decode.opcode[2] ),
    .Y(_0260_));
 sky130_fd_sc_hd__nor2_2 _0665_ (.A(_0259_),
    .B(_0260_),
    .Y(_0261_));
 sky130_fd_sc_hd__and2b_1 _0666_ (.A_N(_0258_),
    .B(_0261_),
    .X(_0262_));
 sky130_fd_sc_hd__o21a_1 _0667_ (.A1(\cpu.decode.co_ebreak ),
    .A2(_0255_),
    .B1(_0262_),
    .X(_0263_));
 sky130_fd_sc_hd__a31o_1 _0668_ (.A1(_0254_),
    .A2(_0258_),
    .A3(_0261_),
    .B1(\cpu.gen_csr.csr.o_new_irq ),
    .X(_0264_));
 sky130_fd_sc_hd__or2_1 _0669_ (.A(\cpu.state.gen_csr.misalign_trap_sync_r ),
    .B(_0264_),
    .X(_0265_));
 sky130_fd_sc_hd__buf_2 _0670_ (.A(_0265_),
    .X(_0266_));
 sky130_fd_sc_hd__and3_1 _0671_ (.A(\cpu.decode.op21 ),
    .B(_0258_),
    .C(_0261_),
    .X(_0267_));
 sky130_fd_sc_hd__or2_1 _0672_ (.A(_0266_),
    .B(_0267_),
    .X(_0268_));
 sky130_fd_sc_hd__nor2_1 _0673_ (.A(_0263_),
    .B(_0268_),
    .Y(_0269_));
 sky130_fd_sc_hd__a221o_1 _0674_ (.A1(_0256_),
    .A2(_0263_),
    .B1(_0269_),
    .B2(\cpu.immdec.gen_immdec_w_eq_1.imm24_20[0] ),
    .C1(_0266_),
    .X(_0270_));
 sky130_fd_sc_hd__mux2_1 _0675_ (.A0(\cpu.csr_imm ),
    .A1(_0270_),
    .S(_0252_),
    .X(_0271_));
 sky130_fd_sc_hd__clkbuf_1 _0676_ (.A(_0271_),
    .X(net174));
 sky130_fd_sc_hd__nor2_2 _0677_ (.A(\cpu.state.gen_csr.misalign_trap_sync_r ),
    .B(_0264_),
    .Y(_0272_));
 sky130_fd_sc_hd__and3b_1 _0678_ (.A_N(_0263_),
    .B(_0272_),
    .C(\cpu.immdec.gen_immdec_w_eq_1.imm24_20[1] ),
    .X(_0273_));
 sky130_fd_sc_hd__a311o_1 _0679_ (.A1(\cpu.decode.op26 ),
    .A2(\cpu.decode.co_ebreak ),
    .A3(_0262_),
    .B1(_0267_),
    .C1(_0273_),
    .X(_0274_));
 sky130_fd_sc_hd__mux2_1 _0680_ (.A0(\cpu.immdec.gen_immdec_w_eq_1.imm19_12_20[5] ),
    .A1(_0274_),
    .S(_0252_),
    .X(_0275_));
 sky130_fd_sc_hd__clkbuf_1 _0681_ (.A(_0275_),
    .X(net175));
 sky130_fd_sc_hd__buf_2 _0682_ (.A(\rf_ram_if.rtrig0 ),
    .X(_0276_));
 sky130_fd_sc_hd__and2b_1 _0683_ (.A_N(_0276_),
    .B(\cpu.immdec.gen_immdec_w_eq_1.imm19_12_20[6] ),
    .X(_0277_));
 sky130_fd_sc_hd__a31o_1 _0684_ (.A1(_0276_),
    .A2(\cpu.immdec.gen_immdec_w_eq_1.imm24_20[2] ),
    .A3(_0269_),
    .B1(_0277_),
    .X(net176));
 sky130_fd_sc_hd__and2b_1 _0685_ (.A_N(_0252_),
    .B(\cpu.immdec.gen_immdec_w_eq_1.imm19_12_20[7] ),
    .X(_0278_));
 sky130_fd_sc_hd__a31o_1 _0686_ (.A1(_0276_),
    .A2(\cpu.immdec.gen_immdec_w_eq_1.imm24_20[3] ),
    .A3(_0269_),
    .B1(_0278_),
    .X(net177));
 sky130_fd_sc_hd__and2b_1 _0687_ (.A_N(_0252_),
    .B(\cpu.immdec.gen_immdec_w_eq_1.imm19_12_20[8] ),
    .X(_0279_));
 sky130_fd_sc_hd__a31o_1 _0688_ (.A1(_0276_),
    .A2(\cpu.immdec.gen_immdec_w_eq_1.imm24_20[4] ),
    .A3(_0269_),
    .B1(_0279_),
    .X(net178));
 sky130_fd_sc_hd__o21a_1 _0689_ (.A1(_0263_),
    .A2(_0268_),
    .B1(_0276_),
    .X(net179));
 sky130_fd_sc_hd__nor2_1 _0690_ (.A(\rf_ram_if.rtrig0 ),
    .B(_0266_),
    .Y(_0280_));
 sky130_fd_sc_hd__inv_2 _0691_ (.A(_0280_),
    .Y(net189));
 sky130_fd_sc_hd__o21ai_1 _0692_ (.A1(_0255_),
    .A2(_0266_),
    .B1(_0276_),
    .Y(_0281_));
 sky130_fd_sc_hd__o21a_1 _0693_ (.A1(\cpu.immdec.gen_immdec_w_eq_1.imm11_7[0] ),
    .A2(net189),
    .B1(_0281_),
    .X(net184));
 sky130_fd_sc_hd__and2b_1 _0694_ (.A_N(_0252_),
    .B(\cpu.immdec.gen_immdec_w_eq_1.imm11_7[1] ),
    .X(_0282_));
 sky130_fd_sc_hd__a311o_1 _0695_ (.A1(_0276_),
    .A2(\cpu.decode.op26 ),
    .A3(\cpu.decode.co_ebreak ),
    .B1(_0266_),
    .C1(_0282_),
    .X(net185));
 sky130_fd_sc_hd__and2_1 _0696_ (.A(\cpu.immdec.gen_immdec_w_eq_1.imm11_7[2] ),
    .B(_0280_),
    .X(_0283_));
 sky130_fd_sc_hd__clkbuf_1 _0697_ (.A(_0283_),
    .X(net186));
 sky130_fd_sc_hd__and2_1 _0698_ (.A(\cpu.immdec.gen_immdec_w_eq_1.imm11_7[3] ),
    .B(_0280_),
    .X(_0284_));
 sky130_fd_sc_hd__clkbuf_1 _0699_ (.A(_0284_),
    .X(net187));
 sky130_fd_sc_hd__and2_1 _0700_ (.A(\cpu.immdec.gen_immdec_w_eq_1.imm11_7[4] ),
    .B(_0280_),
    .X(_0285_));
 sky130_fd_sc_hd__clkbuf_1 _0701_ (.A(_0285_),
    .X(net188));
 sky130_fd_sc_hd__mux2_1 _0702_ (.A0(\rf_ram_if.wdata0_r[0] ),
    .A1(\rf_ram_if.wdata1_r[0] ),
    .S(_0252_),
    .X(_0286_));
 sky130_fd_sc_hd__clkbuf_1 _0703_ (.A(_0286_),
    .X(net190));
 sky130_fd_sc_hd__mux2_1 _0704_ (.A0(\rf_ram_if.wdata0_r[1] ),
    .A1(\rf_ram_if.wdata1_r[1] ),
    .S(_0252_),
    .X(_0287_));
 sky130_fd_sc_hd__clkbuf_1 _0705_ (.A(_0287_),
    .X(net191));
 sky130_fd_sc_hd__buf_2 _0706_ (.A(\cpu.branch_op ),
    .X(_0288_));
 sky130_fd_sc_hd__buf_2 _0707_ (.A(\cpu.decode.opcode[0] ),
    .X(_0289_));
 sky130_fd_sc_hd__buf_2 _0708_ (.A(_0259_),
    .X(_0290_));
 sky130_fd_sc_hd__nand2_1 _0709_ (.A(_0290_),
    .B(net136),
    .Y(_0291_));
 sky130_fd_sc_hd__a21o_1 _0710_ (.A1(\cpu.decode.opcode[2] ),
    .A2(\cpu.decode.co_ebreak ),
    .B1(_0290_),
    .X(_0292_));
 sky130_fd_sc_hd__nor3_1 _0711_ (.A(\cpu.decode.opcode[0] ),
    .B(\cpu.decode.opcode[1] ),
    .C(\cpu.decode.opcode[2] ),
    .Y(_0293_));
 sky130_fd_sc_hd__a221o_1 _0712_ (.A1(_0289_),
    .A2(\cpu.decode.opcode[1] ),
    .B1(_0291_),
    .B2(_0292_),
    .C1(_0293_),
    .X(_0294_));
 sky130_fd_sc_hd__and3_1 _0713_ (.A(net137),
    .B(\cpu.ctrl.pc_plus_offset_cy_r ),
    .C(_0294_),
    .X(_0295_));
 sky130_fd_sc_hd__a21oi_1 _0714_ (.A1(net137),
    .A2(_0294_),
    .B1(\cpu.ctrl.pc_plus_offset_cy_r ),
    .Y(_0296_));
 sky130_fd_sc_hd__or2_1 _0715_ (.A(_0295_),
    .B(_0296_),
    .X(_0297_));
 sky130_fd_sc_hd__buf_2 _0716_ (.A(\cpu.decode.co_mem_word ),
    .X(_0298_));
 sky130_fd_sc_hd__nor2_1 _0717_ (.A(_0260_),
    .B(_0298_),
    .Y(_0299_));
 sky130_fd_sc_hd__buf_2 _0718_ (.A(\cpu.bufreg.i_right_shift_op ),
    .X(_0300_));
 sky130_fd_sc_hd__or4_1 _0719_ (.A(net118),
    .B(net119),
    .C(net116),
    .D(net117),
    .X(_0301_));
 sky130_fd_sc_hd__nor2_1 _0720_ (.A(net120),
    .B(_0301_),
    .Y(_0302_));
 sky130_fd_sc_hd__xor2_1 _0721_ (.A(net121),
    .B(_0302_),
    .X(_0303_));
 sky130_fd_sc_hd__or2_1 _0722_ (.A(\cpu.state.init_done ),
    .B(\cpu.gen_csr.csr.o_new_irq ),
    .X(_0304_));
 sky130_fd_sc_hd__and2b_1 _0723_ (.A_N(\cpu.bufreg.i_right_shift_op ),
    .B(\cpu.decode.co_mem_word ),
    .X(_0305_));
 sky130_fd_sc_hd__and2b_1 _0724_ (.A_N(\cpu.decode.co_mem_word ),
    .B(\cpu.bne_or_bge ),
    .X(_0306_));
 sky130_fd_sc_hd__inv_2 _0725_ (.A(\cpu.decode.opcode[0] ),
    .Y(_0307_));
 sky130_fd_sc_hd__o211ai_1 _0726_ (.A1(_0305_),
    .A2(_0306_),
    .B1(_0259_),
    .C1(_0307_),
    .Y(_0308_));
 sky130_fd_sc_hd__inv_2 _0727_ (.A(\cpu.bufreg.i_right_shift_op ),
    .Y(_0309_));
 sky130_fd_sc_hd__buf_2 _0728_ (.A(\cpu.state.cnt_r[3] ),
    .X(_0310_));
 sky130_fd_sc_hd__clkbuf_4 _0729_ (.A(\cpu.bufreg2.i_bytecnt[1] ),
    .X(_0311_));
 sky130_fd_sc_hd__buf_2 _0730_ (.A(\cpu.state.o_cnt[2] ),
    .X(_0312_));
 sky130_fd_sc_hd__nand4_1 _0731_ (.A(_0310_),
    .B(_0311_),
    .C(_0312_),
    .D(\cpu.bufreg2.i_bytecnt[0] ),
    .Y(_0313_));
 sky130_fd_sc_hd__buf_2 _0732_ (.A(_0313_),
    .X(_0314_));
 sky130_fd_sc_hd__nor2_1 _0733_ (.A(_0309_),
    .B(_0314_),
    .Y(_0315_));
 sky130_fd_sc_hd__inv_2 _0734_ (.A(_0298_),
    .Y(_0316_));
 sky130_fd_sc_hd__o311a_1 _0735_ (.A1(_0304_),
    .A2(_0308_),
    .A3(_0315_),
    .B1(_0316_),
    .C1(\cpu.decode.opcode[2] ),
    .X(_0317_));
 sky130_fd_sc_hd__mux2_1 _0736_ (.A0(net123),
    .A1(_0303_),
    .S(_0317_),
    .X(_0318_));
 sky130_fd_sc_hd__or2_1 _0737_ (.A(_0300_),
    .B(_0318_),
    .X(_0319_));
 sky130_fd_sc_hd__nor2_1 _0738_ (.A(\cpu.state.init_done ),
    .B(\cpu.gen_csr.csr.o_new_irq ),
    .Y(_0320_));
 sky130_fd_sc_hd__nand2_1 _0739_ (.A(\cpu.decode.opcode[2] ),
    .B(_0308_),
    .Y(_0321_));
 sky130_fd_sc_hd__or4_2 _0740_ (.A(_0310_),
    .B(\cpu.state.cnt_r[0] ),
    .C(\cpu.state.cnt_r[1] ),
    .D(\cpu.state.cnt_r[2] ),
    .X(_0322_));
 sky130_fd_sc_hd__o311a_1 _0741_ (.A1(\cpu.branch_op ),
    .A2(_0265_),
    .A3(_0320_),
    .B1(_0321_),
    .C1(_0322_),
    .X(_0323_));
 sky130_fd_sc_hd__a31o_2 _0742_ (.A1(\cpu.state.init_done ),
    .A2(_0299_),
    .A3(_0319_),
    .B1(_0323_),
    .X(_0324_));
 sky130_fd_sc_hd__nand2_1 _0743_ (.A(_0290_),
    .B(_0289_),
    .Y(_0325_));
 sky130_fd_sc_hd__or2_1 _0744_ (.A(_0260_),
    .B(_0325_),
    .X(_0326_));
 sky130_fd_sc_hd__or4b_1 _0745_ (.A(\cpu.decode.opcode[0] ),
    .B(\cpu.decode.opcode[1] ),
    .C(\cpu.decode.opcode[2] ),
    .D_N(net136),
    .X(_0327_));
 sky130_fd_sc_hd__mux2_1 _0746_ (.A0(\cpu.immdec.gen_immdec_w_eq_1.imm11_7[0] ),
    .A1(\cpu.immdec.gen_immdec_w_eq_1.imm24_20[0] ),
    .S(_0327_),
    .X(_0328_));
 sky130_fd_sc_hd__and4_1 _0747_ (.A(\cpu.state.cnt_r[3] ),
    .B(\cpu.bufreg2.i_bytecnt[1] ),
    .C(\cpu.state.o_cnt[2] ),
    .D(\cpu.bufreg2.i_bytecnt[0] ),
    .X(_0329_));
 sky130_fd_sc_hd__o311a_1 _0748_ (.A1(_0259_),
    .A2(_0260_),
    .A3(_0309_),
    .B1(\cpu.immdec.gen_immdec_w_eq_1.imm31 ),
    .C1(_0329_),
    .X(_0330_));
 sky130_fd_sc_hd__a21oi_1 _0749_ (.A1(_0314_),
    .A2(_0328_),
    .B1(_0330_),
    .Y(_0331_));
 sky130_fd_sc_hd__buf_2 _0750_ (.A(\cpu.bufreg2.i_bytecnt[0] ),
    .X(_0332_));
 sky130_fd_sc_hd__a21oi_1 _0751_ (.A1(_0312_),
    .A2(_0332_),
    .B1(_0311_),
    .Y(_0333_));
 sky130_fd_sc_hd__nor3_1 _0752_ (.A(_0326_),
    .B(_0331_),
    .C(_0333_),
    .Y(_0334_));
 sky130_fd_sc_hd__a31oi_1 _0753_ (.A1(\cpu.bufreg.data[0] ),
    .A2(_0324_),
    .A3(_0326_),
    .B1(_0334_),
    .Y(_0335_));
 sky130_fd_sc_hd__and2_1 _0754_ (.A(_0297_),
    .B(_0335_),
    .X(_0336_));
 sky130_fd_sc_hd__nor3_2 _0755_ (.A(_0311_),
    .B(_0312_),
    .C(\cpu.bufreg2.i_bytecnt[0] ),
    .Y(_0337_));
 sky130_fd_sc_hd__and2_1 _0756_ (.A(\cpu.state.cnt_r[0] ),
    .B(_0337_),
    .X(_0338_));
 sky130_fd_sc_hd__nor2_1 _0757_ (.A(_0297_),
    .B(_0335_),
    .Y(_0339_));
 sky130_fd_sc_hd__or3_1 _0758_ (.A(_0336_),
    .B(_0338_),
    .C(_0339_),
    .X(_0340_));
 sky130_fd_sc_hd__nand2_1 _0759_ (.A(_0288_),
    .B(_0340_),
    .Y(_0341_));
 sky130_fd_sc_hd__clkbuf_4 _0760_ (.A(_0324_),
    .X(_0342_));
 sky130_fd_sc_hd__a21o_1 _0761_ (.A1(\cpu.bufreg.data[0] ),
    .A2(_0342_),
    .B1(_0288_),
    .X(_0343_));
 sky130_fd_sc_hd__nor2_1 _0762_ (.A(_0326_),
    .B(_0340_),
    .Y(_0344_));
 sky130_fd_sc_hd__inv_2 _0763_ (.A(\cpu.bne_or_bge ),
    .Y(_0345_));
 sky130_fd_sc_hd__a21oi_1 _0764_ (.A1(_0332_),
    .A2(_0345_),
    .B1(_0311_),
    .Y(_0346_));
 sky130_fd_sc_hd__or3b_1 _0765_ (.A(_0298_),
    .B(_0346_),
    .C_N(\cpu.mem_if.signbit ),
    .X(_0347_));
 sky130_fd_sc_hd__mux4_1 _0766_ (.A0(net100),
    .A1(net130),
    .A2(net107),
    .A3(net116),
    .S0(\cpu.bufreg.data[0] ),
    .S1(\cpu.bufreg.data[1] ),
    .X(_0348_));
 sky130_fd_sc_hd__o21ai_1 _0767_ (.A1(_0298_),
    .A2(_0346_),
    .B1(_0348_),
    .Y(_0349_));
 sky130_fd_sc_hd__o21ai_1 _0768_ (.A1(_0300_),
    .A2(_0347_),
    .B1(_0349_),
    .Y(_0350_));
 sky130_fd_sc_hd__and2_1 _0769_ (.A(net137),
    .B(\cpu.ctrl.pc_plus_4_cy_r ),
    .X(_0351_));
 sky130_fd_sc_hd__nor2_1 _0770_ (.A(net137),
    .B(\cpu.ctrl.pc_plus_4_cy_r ),
    .Y(_0352_));
 sky130_fd_sc_hd__nor2_1 _0771_ (.A(_0351_),
    .B(_0352_),
    .Y(_0353_));
 sky130_fd_sc_hd__a21oi_1 _0772_ (.A1(\cpu.state.cnt_r[2] ),
    .A2(_0337_),
    .B1(_0353_),
    .Y(_0354_));
 sky130_fd_sc_hd__and3_1 _0773_ (.A(\cpu.state.cnt_r[2] ),
    .B(_0337_),
    .C(_0353_),
    .X(_0355_));
 sky130_fd_sc_hd__nor2_1 _0774_ (.A(_0354_),
    .B(_0355_),
    .Y(_0356_));
 sky130_fd_sc_hd__inv_2 _0775_ (.A(_0311_),
    .Y(_0357_));
 sky130_fd_sc_hd__or3b_1 _0776_ (.A(\cpu.decode.op26 ),
    .B(\cpu.decode.co_ebreak ),
    .C_N(_0262_),
    .X(_0358_));
 sky130_fd_sc_hd__nor2_1 _0777_ (.A(\cpu.decode.op22 ),
    .B(_0358_),
    .Y(_0359_));
 sky130_fd_sc_hd__o21ba_1 _0778_ (.A1(_0332_),
    .A2(\cpu.gen_csr.csr.mstatus_mie ),
    .B1_N(_0312_),
    .X(_0360_));
 sky130_fd_sc_hd__a32o_1 _0779_ (.A1(_0312_),
    .A2(_0332_),
    .A3(\cpu.state.cnt_r[0] ),
    .B1(_0360_),
    .B2(_0310_),
    .X(_0361_));
 sky130_fd_sc_hd__a22o_1 _0780_ (.A1(\cpu.gen_csr.csr.mcause31 ),
    .A2(_0329_),
    .B1(_0337_),
    .B2(\cpu.gen_csr.csr.mcause3_0[0] ),
    .X(_0362_));
 sky130_fd_sc_hd__inv_2 _0781_ (.A(\cpu.decode.co_ebreak ),
    .Y(_0363_));
 sky130_fd_sc_hd__and3_1 _0782_ (.A(\cpu.decode.op21 ),
    .B(_0363_),
    .C(_0262_),
    .X(_0364_));
 sky130_fd_sc_hd__mux2_1 _0783_ (.A0(\rf_ram_if.rdata1 ),
    .A1(net65),
    .S(\rf_ram_if.rtrig1 ),
    .X(_0365_));
 sky130_fd_sc_hd__a32o_1 _0784_ (.A1(_0322_),
    .A2(_0362_),
    .A3(_0364_),
    .B1(_0365_),
    .B2(_0263_),
    .X(_0366_));
 sky130_fd_sc_hd__a31o_1 _0785_ (.A1(_0357_),
    .A2(_0359_),
    .A3(_0361_),
    .B1(_0366_),
    .X(_0367_));
 sky130_fd_sc_hd__a31o_1 _0786_ (.A1(_0288_),
    .A2(_0289_),
    .A3(_0356_),
    .B1(_0367_),
    .X(_0368_));
 sky130_fd_sc_hd__a31o_1 _0787_ (.A1(_0307_),
    .A2(_0260_),
    .A3(_0350_),
    .B1(_0368_),
    .X(_0369_));
 sky130_fd_sc_hd__a211o_2 _0788_ (.A1(_0313_),
    .A2(_0328_),
    .B1(_0330_),
    .C1(net136),
    .X(_0370_));
 sky130_fd_sc_hd__inv_2 _0789_ (.A(net136),
    .Y(_0371_));
 sky130_fd_sc_hd__or2_2 _0790_ (.A(_0371_),
    .B(_0365_),
    .X(_0372_));
 sky130_fd_sc_hd__and2_1 _0791_ (.A(_0370_),
    .B(_0372_),
    .X(_0373_));
 sky130_fd_sc_hd__a31o_1 _0792_ (.A1(\cpu.alu.i_rs1 ),
    .A2(_0370_),
    .A3(_0372_),
    .B1(_0345_),
    .X(_0374_));
 sky130_fd_sc_hd__nand3_1 _0793_ (.A(\cpu.alu.i_rs1 ),
    .B(_0316_),
    .C(_0373_),
    .Y(_0375_));
 sky130_fd_sc_hd__o2111a_1 _0794_ (.A1(\cpu.alu.i_rs1 ),
    .A2(_0373_),
    .B1(_0374_),
    .C1(_0375_),
    .D1(_0300_),
    .X(_0376_));
 sky130_fd_sc_hd__a31o_1 _0795_ (.A1(\cpu.alu.cmp_r ),
    .A2(_0305_),
    .A3(_0338_),
    .B1(_0376_),
    .X(_0377_));
 sky130_fd_sc_hd__or2_1 _0796_ (.A(\cpu.alu.add_cy_r ),
    .B(\cpu.alu.i_rs1 ),
    .X(_0378_));
 sky130_fd_sc_hd__nand2_1 _0797_ (.A(\cpu.alu.add_cy_r ),
    .B(\cpu.alu.i_rs1 ),
    .Y(_0379_));
 sky130_fd_sc_hd__and2_1 _0798_ (.A(_0378_),
    .B(_0379_),
    .X(_0380_));
 sky130_fd_sc_hd__inv_2 _0799_ (.A(_0380_),
    .Y(_0381_));
 sky130_fd_sc_hd__a211o_1 _0800_ (.A1(net136),
    .A2(\cpu.bufreg.i_sh_signed ),
    .B1(_0257_),
    .C1(\cpu.branch_op ),
    .X(_0382_));
 sky130_fd_sc_hd__a21oi_1 _0801_ (.A1(_0370_),
    .A2(_0372_),
    .B1(_0382_),
    .Y(_0383_));
 sky130_fd_sc_hd__and3_1 _0802_ (.A(_0370_),
    .B(_0372_),
    .C(_0382_),
    .X(_0384_));
 sky130_fd_sc_hd__nor2_1 _0803_ (.A(_0383_),
    .B(_0384_),
    .Y(_0385_));
 sky130_fd_sc_hd__xnor2_1 _0804_ (.A(_0381_),
    .B(_0385_),
    .Y(_0386_));
 sky130_fd_sc_hd__a22o_1 _0805_ (.A1(\cpu.bufreg.data[0] ),
    .A2(_0324_),
    .B1(_0386_),
    .B2(_0258_),
    .X(_0387_));
 sky130_fd_sc_hd__buf_2 _0806_ (.A(\cpu.decode.opcode[2] ),
    .X(_0388_));
 sky130_fd_sc_hd__o2111a_1 _0807_ (.A1(_0377_),
    .A2(_0387_),
    .B1(_0290_),
    .C1(_0307_),
    .D1(_0388_),
    .X(_0389_));
 sky130_fd_sc_hd__o31a_1 _0808_ (.A1(_0344_),
    .A2(_0369_),
    .A3(_0389_),
    .B1(_0272_),
    .X(_0390_));
 sky130_fd_sc_hd__a31o_1 _0809_ (.A1(_0266_),
    .A2(_0341_),
    .A3(_0343_),
    .B1(_0390_),
    .X(\cpu.o_wdata0 ));
 sky130_fd_sc_hd__mux2_1 _0810_ (.A0(\cpu.alu.i_rs1 ),
    .A1(\cpu.csr_imm ),
    .S(_0300_),
    .X(_0391_));
 sky130_fd_sc_hd__nand2_1 _0811_ (.A(\cpu.bne_or_bge ),
    .B(_0298_),
    .Y(_0392_));
 sky130_fd_sc_hd__o21ai_1 _0812_ (.A1(_0316_),
    .A2(_0391_),
    .B1(\cpu.bne_or_bge ),
    .Y(_0393_));
 sky130_fd_sc_hd__a32o_1 _0813_ (.A1(_0257_),
    .A2(_0391_),
    .A3(_0392_),
    .B1(_0393_),
    .B2(_0367_),
    .X(_0394_));
 sky130_fd_sc_hd__and2_1 _0814_ (.A(_0272_),
    .B(_0394_),
    .X(_0395_));
 sky130_fd_sc_hd__a21o_1 _0815_ (.A1(net137),
    .A2(_0266_),
    .B1(_0395_),
    .X(\cpu.o_wdata1 ));
 sky130_fd_sc_hd__a21bo_1 _0816_ (.A1(_0378_),
    .A2(_0385_),
    .B1_N(_0379_),
    .X(_0396_));
 sky130_fd_sc_hd__clkbuf_4 _0817_ (.A(_0322_),
    .X(_0397_));
 sky130_fd_sc_hd__mux2_1 _0818_ (.A0(_0382_),
    .A1(_0396_),
    .S(_0397_),
    .X(_0398_));
 sky130_fd_sc_hd__clkbuf_1 _0819_ (.A(_0398_),
    .X(_0001_));
 sky130_fd_sc_hd__a22o_1 _0820_ (.A1(\rf_ram_if.rtrig1 ),
    .A2(\rf_ram_if.wen0_r ),
    .B1(\rf_ram_if.wen1_r ),
    .B2(_0276_),
    .X(net192));
 sky130_fd_sc_hd__or2_1 _0821_ (.A(\cpu.bne_or_bge ),
    .B(\cpu.bufreg.data[0] ),
    .X(_0399_));
 sky130_fd_sc_hd__a21o_1 _0822_ (.A1(\cpu.bufreg.data[1] ),
    .A2(_0399_),
    .B1(_0298_),
    .X(net135));
 sky130_fd_sc_hd__inv_2 _0823_ (.A(\cpu.bufreg.data[1] ),
    .Y(_0400_));
 sky130_fd_sc_hd__o21ai_1 _0824_ (.A1(_0400_),
    .A2(\cpu.bufreg.data[0] ),
    .B1(_0316_),
    .Y(net134));
 sky130_fd_sc_hd__a21o_1 _0825_ (.A1(_0400_),
    .A2(_0399_),
    .B1(_0298_),
    .X(net133));
 sky130_fd_sc_hd__nand2_4 _0826_ (.A(_0320_),
    .B(_0321_),
    .Y(_0401_));
 sky130_fd_sc_hd__and2_1 _0827_ (.A(_0397_),
    .B(_0401_),
    .X(_0402_));
 sky130_fd_sc_hd__o21a_1 _0828_ (.A1(_0351_),
    .A2(_0355_),
    .B1(_0402_),
    .X(_0003_));
 sky130_fd_sc_hd__o21a_1 _0829_ (.A1(_0295_),
    .A2(_0339_),
    .B1(_0402_),
    .X(_0004_));
 sky130_fd_sc_hd__o21ai_1 _0830_ (.A1(_0307_),
    .A2(\cpu.decode.opcode[1] ),
    .B1(\cpu.branch_op ),
    .Y(_0403_));
 sky130_fd_sc_hd__and3_1 _0831_ (.A(\cpu.alu.i_rs1 ),
    .B(\cpu.bufreg.c_r ),
    .C(_0403_),
    .X(_0404_));
 sky130_fd_sc_hd__a21oi_1 _0832_ (.A1(\cpu.alu.i_rs1 ),
    .A2(_0403_),
    .B1(\cpu.bufreg.c_r ),
    .Y(_0405_));
 sky130_fd_sc_hd__or2_1 _0833_ (.A(_0404_),
    .B(_0405_),
    .X(_0406_));
 sky130_fd_sc_hd__xnor2_1 _0834_ (.A(_0289_),
    .B(\cpu.decode.opcode[1] ),
    .Y(_0407_));
 sky130_fd_sc_hd__and3_1 _0835_ (.A(\cpu.branch_op ),
    .B(_0338_),
    .C(_0407_),
    .X(_0408_));
 sky130_fd_sc_hd__or4_1 _0836_ (.A(\cpu.decode.opcode[2] ),
    .B(_0331_),
    .C(_0406_),
    .D(_0408_),
    .X(_0409_));
 sky130_fd_sc_hd__inv_2 _0837_ (.A(_0409_),
    .Y(_0410_));
 sky130_fd_sc_hd__o21a_1 _0838_ (.A1(_0404_),
    .A2(_0410_),
    .B1(_0342_),
    .X(_0002_));
 sky130_fd_sc_hd__nor4_2 _0839_ (.A(_0310_),
    .B(\cpu.state.cnt_r[0] ),
    .C(\cpu.state.cnt_r[1] ),
    .D(\cpu.state.cnt_r[2] ),
    .Y(_0411_));
 sky130_fd_sc_hd__nor2_1 _0840_ (.A(_0288_),
    .B(_0388_),
    .Y(_0412_));
 sky130_fd_sc_hd__o2bb2a_1 _0841_ (.A1_N(\cpu.bufreg.data[0] ),
    .A2_N(_0257_),
    .B1(_0316_),
    .B2(_0400_),
    .X(_0413_));
 sky130_fd_sc_hd__and4_1 _0842_ (.A(\cpu.state.init_done ),
    .B(_0411_),
    .C(_0412_),
    .D(_0413_),
    .X(_0414_));
 sky130_fd_sc_hd__clkbuf_1 _0843_ (.A(_0414_),
    .X(net99));
 sky130_fd_sc_hd__buf_2 _0844_ (.A(net67),
    .X(_0415_));
 sky130_fd_sc_hd__and2b_1 _0845_ (.A_N(_0415_),
    .B(\cpu.state.ibus_cyc ),
    .X(_0416_));
 sky130_fd_sc_hd__clkbuf_1 _0846_ (.A(_0416_),
    .X(net169));
 sky130_fd_sc_hd__or2_2 _0847_ (.A(net171),
    .B(net172),
    .X(_0417_));
 sky130_fd_sc_hd__nand2_1 _0848_ (.A(net171),
    .B(net172),
    .Y(_0418_));
 sky130_fd_sc_hd__nand2_1 _0849_ (.A(_0417_),
    .B(_0418_),
    .Y(net182));
 sky130_fd_sc_hd__xnor2_1 _0850_ (.A(net173),
    .B(_0417_),
    .Y(net183));
 sky130_fd_sc_hd__clkbuf_4 _0851_ (.A(net34),
    .X(_0419_));
 sky130_fd_sc_hd__clkbuf_4 _0852_ (.A(_0419_),
    .X(_0420_));
 sky130_fd_sc_hd__nor2_1 _0853_ (.A(_0388_),
    .B(_0413_),
    .Y(_0421_));
 sky130_fd_sc_hd__o211ai_1 _0854_ (.A1(\cpu.alu.cmp_r ),
    .A2(_0338_),
    .B1(_0309_),
    .C1(_0316_),
    .Y(_0422_));
 sky130_fd_sc_hd__and3b_1 _0855_ (.A_N(_0382_),
    .B(_0372_),
    .C(_0370_),
    .X(_0423_));
 sky130_fd_sc_hd__a21boi_1 _0856_ (.A1(_0370_),
    .A2(_0372_),
    .B1_N(_0382_),
    .Y(_0424_));
 sky130_fd_sc_hd__o21ai_1 _0857_ (.A1(_0300_),
    .A2(\cpu.bne_or_bge ),
    .B1(_0298_),
    .Y(_0425_));
 sky130_fd_sc_hd__o311a_1 _0858_ (.A1(\cpu.alu.add_cy_r ),
    .A2(_0423_),
    .A3(_0424_),
    .B1(_0425_),
    .C1(\cpu.alu.i_rs1 ),
    .X(_0426_));
 sky130_fd_sc_hd__nand2_1 _0859_ (.A(\cpu.alu.i_rs1 ),
    .B(_0425_),
    .Y(_0427_));
 sky130_fd_sc_hd__o311a_1 _0860_ (.A1(_0381_),
    .A2(_0383_),
    .A3(_0384_),
    .B1(_0427_),
    .C1(_0379_),
    .X(_0428_));
 sky130_fd_sc_hd__and3_1 _0861_ (.A(_0370_),
    .B(_0372_),
    .C(_0425_),
    .X(_0429_));
 sky130_fd_sc_hd__o21ai_1 _0862_ (.A1(_0426_),
    .A2(_0428_),
    .B1(_0429_),
    .Y(_0430_));
 sky130_fd_sc_hd__o32a_1 _0863_ (.A1(_0429_),
    .A2(_0426_),
    .A3(_0428_),
    .B1(_0298_),
    .B2(_0300_),
    .X(_0431_));
 sky130_fd_sc_hd__a2bb2o_1 _0864_ (.A1_N(_0386_),
    .A2_N(_0422_),
    .B1(_0430_),
    .B2(_0431_),
    .X(_0432_));
 sky130_fd_sc_hd__xnor2_1 _0865_ (.A(_0345_),
    .B(_0432_),
    .Y(_0433_));
 sky130_fd_sc_hd__o211a_1 _0866_ (.A1(_0289_),
    .A2(_0433_),
    .B1(\cpu.bufreg.data[1] ),
    .C1(\cpu.branch_op ),
    .X(_0434_));
 sky130_fd_sc_hd__a21oi_1 _0867_ (.A1(_0290_),
    .A2(_0421_),
    .B1(_0434_),
    .Y(_0435_));
 sky130_fd_sc_hd__or2_1 _0868_ (.A(_0401_),
    .B(_0314_),
    .X(_0436_));
 sky130_fd_sc_hd__nor2_1 _0869_ (.A(_0435_),
    .B(_0436_),
    .Y(_0437_));
 sky130_fd_sc_hd__o21ba_1 _0870_ (.A1(_0420_),
    .A2(_0437_),
    .B1_N(_0415_),
    .X(_0005_));
 sky130_fd_sc_hd__and2_1 _0871_ (.A(_0276_),
    .B(net66),
    .X(_0438_));
 sky130_fd_sc_hd__clkbuf_1 _0872_ (.A(_0438_),
    .X(_0006_));
 sky130_fd_sc_hd__nor2_1 _0873_ (.A(_0401_),
    .B(_0314_),
    .Y(_0439_));
 sky130_fd_sc_hd__and4_1 _0874_ (.A(_0290_),
    .B(_0307_),
    .C(\cpu.decode.opcode[2] ),
    .D(_0439_),
    .X(_0440_));
 sky130_fd_sc_hd__and3_1 _0875_ (.A(\cpu.state.init_done ),
    .B(_0300_),
    .C(net193),
    .X(_0441_));
 sky130_fd_sc_hd__o221a_1 _0876_ (.A1(_0309_),
    .A2(_0318_),
    .B1(_0439_),
    .B2(_0441_),
    .C1(_0299_),
    .X(_0442_));
 sky130_fd_sc_hd__a211oi_1 _0877_ (.A1(_0305_),
    .A2(_0440_),
    .B1(_0442_),
    .C1(net1),
    .Y(_0443_));
 sky130_fd_sc_hd__o31a_1 _0878_ (.A1(_0290_),
    .A2(_0434_),
    .A3(_0436_),
    .B1(_0443_),
    .X(_0444_));
 sky130_fd_sc_hd__nand2_1 _0879_ (.A(\rf_ram_if.rtrig0 ),
    .B(net170),
    .Y(_0445_));
 sky130_fd_sc_hd__or2_1 _0880_ (.A(\rf_ram_if.rtrig0 ),
    .B(net170),
    .X(_0446_));
 sky130_fd_sc_hd__inv_2 _0881_ (.A(net34),
    .Y(_0447_));
 sky130_fd_sc_hd__clkbuf_4 _0882_ (.A(_0447_),
    .X(_0448_));
 sky130_fd_sc_hd__o2111ai_1 _0883_ (.A1(_0435_),
    .A2(_0436_),
    .B1(_0445_),
    .C1(_0446_),
    .D1(_0448_),
    .Y(_0449_));
 sky130_fd_sc_hd__a21oi_1 _0884_ (.A1(_0444_),
    .A2(_0449_),
    .B1(_0415_),
    .Y(_0007_));
 sky130_fd_sc_hd__and2b_1 _0885_ (.A_N(_0415_),
    .B(\rf_ram_if.rreq_r ),
    .X(_0450_));
 sky130_fd_sc_hd__clkbuf_1 _0886_ (.A(_0450_),
    .X(_0008_));
 sky130_fd_sc_hd__mux2_1 _0887_ (.A0(\rf_ram_if.rdata1 ),
    .A1(net66),
    .S(\rf_ram_if.rtrig1 ),
    .X(_0451_));
 sky130_fd_sc_hd__clkbuf_1 _0888_ (.A(_0451_),
    .X(_0009_));
 sky130_fd_sc_hd__nor2_1 _0889_ (.A(net67),
    .B(net34),
    .Y(_0452_));
 sky130_fd_sc_hd__nor2_2 _0890_ (.A(net67),
    .B(_0402_),
    .Y(_0453_));
 sky130_fd_sc_hd__a21oi_1 _0891_ (.A1(_0314_),
    .A2(_0452_),
    .B1(_0453_),
    .Y(_0454_));
 sky130_fd_sc_hd__a31o_1 _0892_ (.A1(\cpu.state.ibus_cyc ),
    .A2(_0314_),
    .A3(_0452_),
    .B1(_0454_),
    .X(_0010_));
 sky130_fd_sc_hd__or3_1 _0893_ (.A(\cpu.immdec.gen_immdec_w_eq_1.imm11_7[2] ),
    .B(\cpu.immdec.gen_immdec_w_eq_1.imm11_7[3] ),
    .C(\cpu.immdec.gen_immdec_w_eq_1.imm11_7[4] ),
    .X(_0455_));
 sky130_fd_sc_hd__nand2_1 _0894_ (.A(_0307_),
    .B(net136),
    .Y(_0456_));
 sky130_fd_sc_hd__a21o_1 _0895_ (.A1(_0325_),
    .A2(_0456_),
    .B1(_0388_),
    .X(_0457_));
 sky130_fd_sc_hd__o311a_1 _0896_ (.A1(\cpu.immdec.gen_immdec_w_eq_1.imm11_7[0] ),
    .A2(\cpu.immdec.gen_immdec_w_eq_1.imm11_7[1] ),
    .A3(_0455_),
    .B1(_0457_),
    .C1(_0401_),
    .X(_0458_));
 sky130_fd_sc_hd__o21a_1 _0897_ (.A1(_0266_),
    .A2(_0458_),
    .B1(_0397_),
    .X(_0459_));
 sky130_fd_sc_hd__mux2_1 _0898_ (.A0(\rf_ram_if.wen0_r ),
    .A1(_0459_),
    .S(_0252_),
    .X(_0460_));
 sky130_fd_sc_hd__clkbuf_1 _0899_ (.A(_0460_),
    .X(_0011_));
 sky130_fd_sc_hd__o211a_1 _0900_ (.A1(_0435_),
    .A2(_0436_),
    .B1(_0444_),
    .C1(_0452_),
    .X(_0461_));
 sky130_fd_sc_hd__and2b_1 _0901_ (.A_N(_0276_),
    .B(_0461_),
    .X(_0462_));
 sky130_fd_sc_hd__clkbuf_1 _0902_ (.A(_0462_),
    .X(_0012_));
 sky130_fd_sc_hd__or2_1 _0903_ (.A(net181),
    .B(_0445_),
    .X(_0463_));
 sky130_fd_sc_hd__nand2_1 _0904_ (.A(net181),
    .B(_0445_),
    .Y(_0464_));
 sky130_fd_sc_hd__and3_1 _0905_ (.A(_0461_),
    .B(_0463_),
    .C(_0464_),
    .X(_0465_));
 sky130_fd_sc_hd__clkbuf_1 _0906_ (.A(_0465_),
    .X(_0013_));
 sky130_fd_sc_hd__or2_1 _0907_ (.A(_0418_),
    .B(_0445_),
    .X(_0466_));
 sky130_fd_sc_hd__a31o_1 _0908_ (.A1(\rf_ram_if.rtrig0 ),
    .A2(net171),
    .A3(net170),
    .B1(net172),
    .X(_0467_));
 sky130_fd_sc_hd__and3_1 _0909_ (.A(_0461_),
    .B(_0466_),
    .C(_0467_),
    .X(_0468_));
 sky130_fd_sc_hd__clkbuf_1 _0910_ (.A(_0468_),
    .X(_0014_));
 sky130_fd_sc_hd__inv_2 _0911_ (.A(net173),
    .Y(_0469_));
 sky130_fd_sc_hd__nor2_1 _0912_ (.A(_0469_),
    .B(_0466_),
    .Y(_0470_));
 sky130_fd_sc_hd__nand2_1 _0913_ (.A(_0469_),
    .B(_0466_),
    .Y(_0471_));
 sky130_fd_sc_hd__and3b_1 _0914_ (.A_N(_0470_),
    .B(_0461_),
    .C(_0471_),
    .X(_0472_));
 sky130_fd_sc_hd__clkbuf_1 _0915_ (.A(_0472_),
    .X(_0015_));
 sky130_fd_sc_hd__o21ai_1 _0916_ (.A1(\cpu.state.cnt_r[0] ),
    .A2(\cpu.state.cnt_r[1] ),
    .B1(_0337_),
    .Y(_0473_));
 sky130_fd_sc_hd__nor2_1 _0917_ (.A(_0401_),
    .B(_0473_),
    .Y(_0474_));
 sky130_fd_sc_hd__a21o_1 _0918_ (.A1(_0401_),
    .A2(_0324_),
    .B1(_0474_),
    .X(_0475_));
 sky130_fd_sc_hd__mux2_1 _0919_ (.A0(\cpu.bufreg.data[0] ),
    .A1(\cpu.bufreg.data[1] ),
    .S(_0475_),
    .X(_0476_));
 sky130_fd_sc_hd__clkbuf_1 _0920_ (.A(_0476_),
    .X(_0016_));
 sky130_fd_sc_hd__o31a_1 _0921_ (.A1(_0388_),
    .A2(_0331_),
    .A3(_0408_),
    .B1(_0406_),
    .X(_0477_));
 sky130_fd_sc_hd__nor3_1 _0922_ (.A(_0401_),
    .B(_0410_),
    .C(_0477_),
    .Y(_0478_));
 sky130_fd_sc_hd__a21o_1 _0923_ (.A1(net89),
    .A2(_0401_),
    .B1(_0478_),
    .X(_0479_));
 sky130_fd_sc_hd__mux2_1 _0924_ (.A0(\cpu.bufreg.data[1] ),
    .A1(_0479_),
    .S(_0475_),
    .X(_0480_));
 sky130_fd_sc_hd__clkbuf_1 _0925_ (.A(_0480_),
    .X(_0017_));
 sky130_fd_sc_hd__o21a_1 _0926_ (.A1(_0263_),
    .A2(_0266_),
    .B1(_0397_),
    .X(_0481_));
 sky130_fd_sc_hd__mux2_1 _0927_ (.A0(\rf_ram_if.wen1_r ),
    .A1(_0481_),
    .S(_0252_),
    .X(_0482_));
 sky130_fd_sc_hd__clkbuf_1 _0928_ (.A(_0482_),
    .X(_0018_));
 sky130_fd_sc_hd__nand4_1 _0929_ (.A(\cpu.gen_csr.csr.mie_mtie ),
    .B(_0419_),
    .C(\cpu.gen_csr.csr.mstatus_mie ),
    .D(net68),
    .Y(_0483_));
 sky130_fd_sc_hd__o2bb2a_1 _0930_ (.A1_N(\cpu.gen_csr.csr.o_new_irq ),
    .A2_N(_0448_),
    .B1(\cpu.gen_csr.csr.timer_irq_r ),
    .B2(_0483_),
    .X(_0484_));
 sky130_fd_sc_hd__nor2_1 _0931_ (.A(_0415_),
    .B(_0484_),
    .Y(_0019_));
 sky130_fd_sc_hd__mux2_1 _0932_ (.A0(\cpu.bufreg.i_sh_signed ),
    .A1(net56),
    .S(_0420_),
    .X(_0485_));
 sky130_fd_sc_hd__clkbuf_1 _0933_ (.A(_0485_),
    .X(_0020_));
 sky130_fd_sc_hd__nor2_1 _0934_ (.A(_0272_),
    .B(_0314_),
    .Y(_0486_));
 sky130_fd_sc_hd__a311o_1 _0935_ (.A1(_0310_),
    .A2(_0337_),
    .A3(_0359_),
    .B1(_0486_),
    .C1(_0267_),
    .X(_0487_));
 sky130_fd_sc_hd__inv_2 _0936_ (.A(_0487_),
    .Y(_0488_));
 sky130_fd_sc_hd__or2b_1 _0937_ (.A(\cpu.gen_csr.csr.mstatus_mpie ),
    .B_N(_0267_),
    .X(_0489_));
 sky130_fd_sc_hd__o211a_1 _0938_ (.A1(_0267_),
    .A2(_0394_),
    .B1(_0487_),
    .C1(_0489_),
    .X(_0490_));
 sky130_fd_sc_hd__a22o_1 _0939_ (.A1(\cpu.gen_csr.csr.mstatus_mie ),
    .A2(_0488_),
    .B1(_0490_),
    .B2(_0272_),
    .X(_0021_));
 sky130_fd_sc_hd__inv_2 _0940_ (.A(\cpu.decode.op22 ),
    .Y(_0491_));
 sky130_fd_sc_hd__nand2_1 _0941_ (.A(_0310_),
    .B(_0312_),
    .Y(_0492_));
 sky130_fd_sc_hd__inv_2 _0942_ (.A(_0332_),
    .Y(_0493_));
 sky130_fd_sc_hd__and3b_1 _0943_ (.A_N(_0492_),
    .B(_0493_),
    .C(_0357_),
    .X(_0494_));
 sky130_fd_sc_hd__nor3b_1 _0944_ (.A(_0491_),
    .B(_0358_),
    .C_N(_0494_),
    .Y(_0495_));
 sky130_fd_sc_hd__mux2_1 _0945_ (.A0(\cpu.gen_csr.csr.mie_mtie ),
    .A1(_0394_),
    .S(_0495_),
    .X(_0496_));
 sky130_fd_sc_hd__and2b_1 _0946_ (.A_N(net67),
    .B(_0496_),
    .X(_0497_));
 sky130_fd_sc_hd__clkbuf_1 _0947_ (.A(_0497_),
    .X(_0022_));
 sky130_fd_sc_hd__mux2_1 _0948_ (.A0(\cpu.gen_csr.csr.mstatus_mpie ),
    .A1(\cpu.gen_csr.csr.mstatus_mie ),
    .S(_0486_),
    .X(_0498_));
 sky130_fd_sc_hd__clkbuf_1 _0949_ (.A(_0498_),
    .X(_0023_));
 sky130_fd_sc_hd__a21oi_1 _0950_ (.A1(_0329_),
    .A2(_0364_),
    .B1(_0266_),
    .Y(_0499_));
 sky130_fd_sc_hd__or2b_1 _0951_ (.A(\cpu.gen_csr.csr.mcause31 ),
    .B_N(_0499_),
    .X(_0500_));
 sky130_fd_sc_hd__o31a_1 _0952_ (.A1(\cpu.gen_csr.csr.o_new_irq ),
    .A2(_0395_),
    .A3(_0499_),
    .B1(_0500_),
    .X(_0024_));
 sky130_fd_sc_hd__inv_2 _0953_ (.A(\cpu.state.gen_csr.misalign_trap_sync_r ),
    .Y(_0501_));
 sky130_fd_sc_hd__a21o_1 _0954_ (.A1(_0501_),
    .A2(\cpu.gen_csr.csr.mcause3_0[1] ),
    .B1(_0264_),
    .X(_0502_));
 sky130_fd_sc_hd__a31o_1 _0955_ (.A1(_0397_),
    .A2(_0337_),
    .A3(_0364_),
    .B1(_0486_),
    .X(_0503_));
 sky130_fd_sc_hd__mux2_1 _0956_ (.A0(\cpu.gen_csr.csr.mcause3_0[0] ),
    .A1(_0502_),
    .S(_0503_),
    .X(_0504_));
 sky130_fd_sc_hd__clkbuf_1 _0957_ (.A(_0504_),
    .X(_0025_));
 sky130_fd_sc_hd__a221o_1 _0958_ (.A1(_0290_),
    .A2(net136),
    .B1(_0501_),
    .B2(\cpu.gen_csr.csr.mcause3_0[2] ),
    .C1(_0264_),
    .X(_0505_));
 sky130_fd_sc_hd__mux2_1 _0959_ (.A0(\cpu.gen_csr.csr.mcause3_0[1] ),
    .A1(_0505_),
    .S(_0503_),
    .X(_0506_));
 sky130_fd_sc_hd__clkbuf_1 _0960_ (.A(_0506_),
    .X(_0026_));
 sky130_fd_sc_hd__a211o_1 _0961_ (.A1(\cpu.gen_csr.csr.mcause3_0[3] ),
    .A2(_0272_),
    .B1(\cpu.gen_csr.csr.o_new_irq ),
    .C1(_0290_),
    .X(_0507_));
 sky130_fd_sc_hd__mux2_1 _0962_ (.A0(\cpu.gen_csr.csr.mcause3_0[2] ),
    .A1(_0507_),
    .S(_0503_),
    .X(_0508_));
 sky130_fd_sc_hd__clkbuf_1 _0963_ (.A(_0508_),
    .X(_0027_));
 sky130_fd_sc_hd__a41o_1 _0964_ (.A1(_0254_),
    .A2(_0363_),
    .A3(_0258_),
    .A4(_0261_),
    .B1(_0395_),
    .X(_0509_));
 sky130_fd_sc_hd__mux2_1 _0965_ (.A0(\cpu.gen_csr.csr.mcause3_0[3] ),
    .A1(_0509_),
    .S(_0503_),
    .X(_0510_));
 sky130_fd_sc_hd__clkbuf_1 _0966_ (.A(_0510_),
    .X(_0028_));
 sky130_fd_sc_hd__mux2_1 _0967_ (.A0(\cpu.immdec.gen_immdec_w_eq_1.imm11_7[1] ),
    .A1(net62),
    .S(_0419_),
    .X(_0511_));
 sky130_fd_sc_hd__o21a_1 _0968_ (.A1(net193),
    .A2(_0457_),
    .B1(_0447_),
    .X(_0512_));
 sky130_fd_sc_hd__mux2_1 _0969_ (.A0(_0511_),
    .A1(\cpu.immdec.gen_immdec_w_eq_1.imm11_7[0] ),
    .S(_0512_),
    .X(_0513_));
 sky130_fd_sc_hd__clkbuf_1 _0970_ (.A(_0513_),
    .X(_0029_));
 sky130_fd_sc_hd__and3b_1 _0971_ (.A_N(_0457_),
    .B(_0397_),
    .C(_0447_),
    .X(_0514_));
 sky130_fd_sc_hd__clkbuf_4 _0972_ (.A(_0419_),
    .X(_0515_));
 sky130_fd_sc_hd__and2_1 _0973_ (.A(_0515_),
    .B(net63),
    .X(_0516_));
 sky130_fd_sc_hd__a221o_1 _0974_ (.A1(\cpu.immdec.gen_immdec_w_eq_1.imm11_7[1] ),
    .A2(_0512_),
    .B1(_0514_),
    .B2(\cpu.immdec.gen_immdec_w_eq_1.imm11_7[2] ),
    .C1(_0516_),
    .X(_0030_));
 sky130_fd_sc_hd__and2_1 _0975_ (.A(_0515_),
    .B(net64),
    .X(_0517_));
 sky130_fd_sc_hd__a221o_1 _0976_ (.A1(\cpu.immdec.gen_immdec_w_eq_1.imm11_7[2] ),
    .A2(_0512_),
    .B1(_0514_),
    .B2(\cpu.immdec.gen_immdec_w_eq_1.imm11_7[3] ),
    .C1(_0517_),
    .X(_0031_));
 sky130_fd_sc_hd__and2_1 _0977_ (.A(_0515_),
    .B(net35),
    .X(_0518_));
 sky130_fd_sc_hd__a221o_1 _0978_ (.A1(\cpu.immdec.gen_immdec_w_eq_1.imm11_7[3] ),
    .A2(_0512_),
    .B1(_0514_),
    .B2(\cpu.immdec.gen_immdec_w_eq_1.imm11_7[4] ),
    .C1(_0518_),
    .X(_0032_));
 sky130_fd_sc_hd__and2_1 _0979_ (.A(_0515_),
    .B(net36),
    .X(_0519_));
 sky130_fd_sc_hd__a221o_1 _0980_ (.A1(\cpu.immdec.gen_immdec_w_eq_1.imm11_7[4] ),
    .A2(_0512_),
    .B1(_0514_),
    .B2(\cpu.immdec.gen_immdec_w_eq_1.imm30_25[0] ),
    .C1(_0519_),
    .X(_0033_));
 sky130_fd_sc_hd__buf_2 _0981_ (.A(_0453_),
    .X(_0520_));
 sky130_fd_sc_hd__and2b_1 _0982_ (.A_N(net67),
    .B(_0402_),
    .X(_0521_));
 sky130_fd_sc_hd__clkbuf_2 _0983_ (.A(_0521_),
    .X(_0522_));
 sky130_fd_sc_hd__buf_2 _0984_ (.A(_0522_),
    .X(_0523_));
 sky130_fd_sc_hd__a22o_1 _0985_ (.A1(net137),
    .A2(_0520_),
    .B1(_0523_),
    .B2(net148),
    .X(_0034_));
 sky130_fd_sc_hd__a22o_1 _0986_ (.A1(net148),
    .A2(_0520_),
    .B1(_0523_),
    .B2(net159),
    .X(_0035_));
 sky130_fd_sc_hd__a22o_1 _0987_ (.A1(net159),
    .A2(_0520_),
    .B1(_0523_),
    .B2(net162),
    .X(_0036_));
 sky130_fd_sc_hd__a22o_1 _0988_ (.A1(net162),
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
    .Y(_0245_));
 sky130_fd_sc_hd__a21oi_1 _1320_ (.A1(_0444_),
    .A2(_0245_),
    .B1(_0415_),
    .Y(_0169_));
 sky130_fd_sc_hd__and2b_1 _1321_ (.A_N(net67),
    .B(\cpu.state.cnt_r[0] ),
    .X(_0246_));
 sky130_fd_sc_hd__clkbuf_1 _1322_ (.A(_0246_),
    .X(_0170_));
 sky130_fd_sc_hd__and2b_1 _1323_ (.A_N(net67),
    .B(\cpu.state.cnt_r[1] ),
    .X(_0247_));
 sky130_fd_sc_hd__clkbuf_1 _1324_ (.A(_0247_),
    .X(_0171_));
 sky130_fd_sc_hd__and2b_1 _1325_ (.A_N(net67),
    .B(\cpu.state.cnt_r[2] ),
    .X(_0248_));
 sky130_fd_sc_hd__clkbuf_1 _1326_ (.A(_0248_),
    .X(_0172_));
 sky130_fd_sc_hd__nand2_1 _1327_ (.A(\cpu.state.init_done ),
    .B(_0314_),
    .Y(_0249_));
 sky130_fd_sc_hd__a21oi_1 _1328_ (.A1(_0436_),
    .A2(_0249_),
    .B1(_0415_),
    .Y(_0173_));
 sky130_fd_sc_hd__and2_1 _1329_ (.A(\cpu.ctrl.i_jump ),
    .B(_0314_),
    .X(_0250_));
 sky130_fd_sc_hd__o211a_1 _1330_ (.A1(_0289_),
    .A2(_0433_),
    .B1(_0439_),
    .C1(_0288_),
    .X(_0251_));
 sky130_fd_sc_hd__o21ba_1 _1331_ (.A1(_0250_),
    .A2(_0251_),
    .B1_N(_0415_),
    .X(_0174_));
 sky130_fd_sc_hd__dfxtp_1 _1332_ (.CLK(clk),
    .D(_0005_),
    .Q(\rf_ram_if.rreq_r ));
 sky130_fd_sc_hd__dfxtp_1 _1333_ (.CLK(clk),
    .D(\rf_ram_if.wdata1_r[1] ),
    .Q(\rf_ram_if.wdata1_r[0] ));
 sky130_fd_sc_hd__dfxtp_1 _1334_ (.CLK(clk),
    .D(\rf_ram_if.wdata1_r[2] ),
    .Q(\rf_ram_if.wdata1_r[1] ));
 sky130_fd_sc_hd__dfxtp_1 _1335_ (.CLK(clk),
    .D(\cpu.o_wdata1 ),
    .Q(\rf_ram_if.wdata1_r[2] ));
 sky130_fd_sc_hd__dfxtp_1 _1336_ (.CLK(clk),
    .D(\rf_ram_if.wdata0_r[1] ),
    .Q(\rf_ram_if.wdata0_r[0] ));
 sky130_fd_sc_hd__dfxtp_1 _1337_ (.CLK(clk),
    .D(\cpu.o_wdata0 ),
    .Q(\rf_ram_if.wdata0_r[1] ));
 sky130_fd_sc_hd__dfxtp_1 _1338_ (.CLK(clk),
    .D(_0006_),
    .Q(\rf_ram_if.rdata0[1] ));
 sky130_fd_sc_hd__dfxtp_1 _1339_ (.CLK(clk),
    .D(_0007_),
    .Q(net170));
 sky130_fd_sc_hd__dfxtp_1 _1340_ (.CLK(clk),
    .D(\rf_ram_if.rtrig0 ),
    .Q(\rf_ram_if.rtrig1 ));
 sky130_fd_sc_hd__dfxtp_1 _1341_ (.CLK(clk),
    .D(_0008_),
    .Q(\rf_ram_if.rgnt ));
 sky130_fd_sc_hd__dfxtp_1 _1342_ (.CLK(clk),
    .D(_0009_),
    .Q(\rf_ram_if.rdata1 ));
 sky130_fd_sc_hd__dfxtp_1 _1343_ (.CLK(clk),
    .D(_0010_),
    .Q(\cpu.state.ibus_cyc ));
 sky130_fd_sc_hd__dfxtp_1 _1344_ (.CLK(clk),
    .D(_0011_),
    .Q(\rf_ram_if.wen0_r ));
 sky130_fd_sc_hd__dfxtp_2 _1345_ (.CLK(clk),
    .D(_0000_),
    .Q(\cpu.alu.i_rs1 ));
 sky130_fd_sc_hd__dfxtp_2 _1346_ (.CLK(clk),
    .D(_0012_),
    .Q(\rf_ram_if.rtrig0 ));
 sky130_fd_sc_hd__dfxtp_1 _1347_ (.CLK(clk),
    .D(_0013_),
    .Q(net171));
 sky130_fd_sc_hd__dfxtp_1 _1348_ (.CLK(clk),
    .D(_0014_),
    .Q(net172));
 sky130_fd_sc_hd__dfxtp_1 _1349_ (.CLK(clk),
    .D(_0015_),
    .Q(net173));
 sky130_fd_sc_hd__dfxtp_2 _1350_ (.CLK(clk),
    .D(_0016_),
    .Q(\cpu.bufreg.data[0] ));
 sky130_fd_sc_hd__dfxtp_2 _1351_ (.CLK(clk),
    .D(_0017_),
    .Q(\cpu.bufreg.data[1] ));
 sky130_fd_sc_hd__dfxtp_1 _1352_ (.CLK(clk),
    .D(_0018_),
    .Q(\rf_ram_if.wen1_r ));
 sky130_fd_sc_hd__dfxtp_1 _1353_ (.CLK(clk),
    .D(_0019_),
    .Q(\cpu.gen_csr.csr.o_new_irq ));
 sky130_fd_sc_hd__dfxtp_1 _1354_ (.CLK(clk),
    .D(_0020_),
    .Q(\cpu.bufreg.i_sh_signed ));
 sky130_fd_sc_hd__dfxtp_1 _1355_ (.CLK(clk),
    .D(_0021_),
    .Q(\cpu.gen_csr.csr.mstatus_mie ));
 sky130_fd_sc_hd__dfxtp_1 _1356_ (.CLK(clk),
    .D(_0022_),
    .Q(\cpu.gen_csr.csr.mie_mtie ));
 sky130_fd_sc_hd__dfxtp_1 _1357_ (.CLK(clk),
    .D(_0023_),
    .Q(\cpu.gen_csr.csr.mstatus_mpie ));
 sky130_fd_sc_hd__dfxtp_1 _1358_ (.CLK(clk),
    .D(_0024_),
    .Q(\cpu.gen_csr.csr.mcause31 ));
 sky130_fd_sc_hd__dfxtp_1 _1359_ (.CLK(clk),
    .D(_0025_),
    .Q(\cpu.gen_csr.csr.mcause3_0[0] ));
 sky130_fd_sc_hd__dfxtp_1 _1360_ (.CLK(clk),
    .D(_0026_),
    .Q(\cpu.gen_csr.csr.mcause3_0[1] ));
 sky130_fd_sc_hd__dfxtp_1 _1361_ (.CLK(clk),
    .D(_0027_),
    .Q(\cpu.gen_csr.csr.mcause3_0[2] ));
 sky130_fd_sc_hd__dfxtp_1 _1362_ (.CLK(clk),
    .D(_0028_),
    .Q(\cpu.gen_csr.csr.mcause3_0[3] ));
 sky130_fd_sc_hd__dfxtp_1 _1363_ (.CLK(clk),
    .D(_0029_),
    .Q(\cpu.immdec.gen_immdec_w_eq_1.imm11_7[0] ));
 sky130_fd_sc_hd__dfxtp_1 _1364_ (.CLK(clk),
    .D(_0030_),
    .Q(\cpu.immdec.gen_immdec_w_eq_1.imm11_7[1] ));
 sky130_fd_sc_hd__dfxtp_1 _1365_ (.CLK(clk),
    .D(_0031_),
    .Q(\cpu.immdec.gen_immdec_w_eq_1.imm11_7[2] ));
 sky130_fd_sc_hd__dfxtp_1 _1366_ (.CLK(clk),
    .D(_0032_),
    .Q(\cpu.immdec.gen_immdec_w_eq_1.imm11_7[3] ));
 sky130_fd_sc_hd__dfxtp_1 _1367_ (.CLK(clk),
    .D(_0033_),
    .Q(\cpu.immdec.gen_immdec_w_eq_1.imm11_7[4] ));
 sky130_fd_sc_hd__dfxtp_1 _1368_ (.CLK(clk),
    .D(_0001_),
    .Q(\cpu.alu.add_cy_r ));
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
    .X(net62));
 sky130_fd_sc_hd__clkbuf_1 input63 (.A(i_ibus_rdt[8]),
    .X(net63));
 sky130_fd_sc_hd__clkbuf_1 input64 (.A(i_ibus_rdt[9]),
    .X(net64));
 sky130_fd_sc_hd__buf_1 input65 (.A(i_rdata[0]),
    .X(net65));
 sky130_fd_sc_hd__buf_1 input66 (.A(i_rdata[1]),
    .X(net66));
 sky130_fd_sc_hd__buf_2 input67 (.A(i_rst),
    .X(net67));
 sky130_fd_sc_hd__buf_1 input68 (.A(i_timer_irq),
    .X(net68));
 sky130_fd_sc_hd__clkbuf_4 output69 (.A(net69),
    .X(o_dbus_adr[10]));
 sky130_fd_sc_hd__buf_2 output70 (.A(net70),
    .X(o_dbus_adr[11]));
 sky130_fd_sc_hd__buf_2 output71 (.A(net71),
    .X(o_dbus_adr[12]));
 sky130_fd_sc_hd__clkbuf_4 output72 (.A(net72),
    .X(o_dbus_adr[13]));
 sky130_fd_sc_hd__buf_2 output73 (.A(net73),
    .X(o_dbus_adr[14]));
 sky130_fd_sc_hd__buf_2 output74 (.A(net74),
    .X(o_dbus_adr[15]));
 sky130_fd_sc_hd__buf_2 output75 (.A(net75),
    .X(o_dbus_adr[16]));
 sky130_fd_sc_hd__buf_2 output76 (.A(net76),
    .X(o_dbus_adr[17]));
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
