dangthanhson2kk4-dotcom/Openlane_SERV_OPT/runs/CTS/results/placement/serv_synth_wrapper.pnl.v

module serv_synth_wrapper (clk,
    i_dbus_ack,
    i_ibus_ack,
    i_rst,
    i_timer_irq,
    o_dbus_cyc,
    o_dbus_we,
    o_ibus_cyc,
    o_wen,
    VPWR,
    VGND,
    i_dbus_rdt,
    i_ibus_rdt,
    i_rdata,
    o_dbus_adr,
    o_dbus_dat,
    o_dbus_sel,
    o_ibus_adr,
    o_raddr,
    o_waddr,
    o_wdata);
 input clk;
 input i_dbus_ack;
 input i_ibus_ack;
 input i_rst;
 input i_timer_irq;
 output o_dbus_cyc;
 output o_dbus_we;
 output o_ibus_cyc;
 output o_wen;
 input VPWR;
 input VGND;
 input [31:0] i_dbus_rdt;
 input [31:0] i_ibus_rdt;
 input [1:0] i_rdata;
 output [31:0] o_dbus_adr;
 output [31:0] o_dbus_dat;
 output [3:0] o_dbus_sel;
 output [31:0] o_ibus_adr;
 output [9:0] o_raddr;
 output [9:0] o_waddr;
 output [1:0] o_wdata;

 wire _0000_;
 wire _0001_;
 wire _0002_;
 wire _0003_;
 wire _0004_;
 wire _0005_;
 wire _0006_;
 wire _0007_;
 wire _0008_;
 wire _0009_;
 wire _0010_;
 wire _0011_;
 wire _0012_;
 wire _0013_;
 wire _0014_;
 wire _0015_;
 wire _0016_;
 wire _0017_;
 wire _0018_;
 wire _0019_;
 wire _0020_;
 wire _0021_;
 wire _0022_;
 wire _0023_;
 wire _0024_;
 wire _0025_;
 wire _0026_;
 wire _0027_;
 wire _0028_;
 wire _0029_;
 wire _0030_;
 wire _0031_;
 wire _0032_;
 wire _0033_;
 wire _0034_;
 wire _0035_;
 wire _0036_;
 wire _0037_;
 wire _0038_;
 wire _0039_;
 wire _0040_;
 wire _0041_;
 wire _0042_;
 wire _0043_;
 wire _0044_;
 wire _0045_;
 wire _0046_;
 wire _0047_;
 wire _0048_;
 wire _0049_;
 wire _0050_;
 wire _0051_;
 wire _0052_;
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
    .VGND(VGND),
    .VNB(VGND),
    .VPB(VPWR),
    .VPWR(VPWR),
    .X(net188));
 sky130_fd_sc_hd__mux2_1 _0702_ (.A0(\rf_ram_if.wdata0_r[0] ),
    .A1(\rf_ram_if.wdata1_r[0] ),
    .S(_0252_),
    .VGND(VGND),
    .VNB(VGND),
    .VPB(VPWR),
    .VPWR(VPWR),
    .X(_0286_));
 sky130_fd_sc_hd__clkbuf_1 _0703_ (.A(_0286_),
    .VGND(VGND),
    .VNB(VGND),
    .VPB(VPWR),
    .VPWR(VPWR),
    .X(net190));
 sky130_fd_sc_hd__mux2_1 _0704_ (.A0(\rf_ram_if.wdata0_r[1] ),
    .A1(\rf_ram_if.wdata1_r[1] ),
    .S(_0252_),
    .VGND(VGND),
    .VNB(VGND),
    .VPB(VPWR),
    .VPWR(VPWR),
    .X(_0287_));
 sky130_fd_sc_hd__clkbuf_1 _0705_ (.A(_0287_),
    .VGND(VGND),
    .VNB(VGND),
    .VPB(VPWR),
    .VPWR(VPWR),
    .X(net191));
 sky130_fd_sc_hd__buf_2 _0706_ (.A(\cpu.branch_op ),
    .VGND(VGND),
    .VNB(VGND),
    .VPB(VPWR),
    .VPWR(VPWR),
    .X(_0288_));
 sky130_fd_sc_hd__buf_2 _0707_ (.A(\cpu.decode.opcode[0] ),
    .VGND(VGND),
    .VNB(VGND),
    .VPB(VPWR),
    .VPWR(VPWR),
    .X(_0289_));
 sky130_fd_sc_hd__buf_2 _0708_ (.A(_0259_),
    .VGND(VGND),
    .VNB(VGND),
    .VPB(VPWR),
    .VPWR(VPWR),
    .X(_0290_));
 sky130_fd_sc_hd__nand2_1 _0709_ (.A(_0290_),
    .B(net136),
    .VGND(VGND),
    .VNB(VGND),
    .VPB(VPWR),
    .VPWR(VPWR),
    .Y(_0291_));
 sky130_fd_sc_hd__a21o_1 _0710_ (.A1(\cpu.decode.opcode[2] ),
    .A2(\cpu.decode.co_ebreak ),
    .B1(_0290_),
    .VGND(VGND),
    .VNB(VGND),
    .VPB(VPWR),
    .VPWR(VPWR),
    .X(_0292_));
 sky130_fd_sc_hd__nor3_1 _0711_ (.A(\cpu.decode.opcode[0] ),
    .B(\cpu.decode.opcode[1] ),
    .C(\cpu.decode.opcode[2] ),
    .VGND(VGND),
    .VNB(VGND),
    .VPB(VPWR),
    .VPWR(VPWR),
    .Y(_0293_));
 sky130_fd_sc_hd__a221o_1 _0712_ (.A1(_0289_),
    .A2(\cpu.decode.opcode[1] ),
    .B1(_0291_),
    .B2(_0292_),
    .C1(_0293_),
    .VGND(VGND),
    .VNB(VGND),
    .VPB(VPWR),
    .VPWR(VPWR),
    .X(_0294_));
 sky130_fd_sc_hd__and3_1 _0713_ (.A(net137),
    .B(\cpu.ctrl.pc_plus_offset_cy_r ),
    .C(_0294_),
    .VGND(VGND),
    .VNB(VGND),
    .VPB(VPWR),
    .VPWR(VPWR),
    .X(_0295_));
 sky130_fd_sc_hd__a21oi_1 _0714_ (.A1(net137),
    .A2(_0294_),
    .B1(\cpu.ctrl.pc_plus_offset_cy_r ),
    .VGND(VGND),
    .VNB(VGND),
    .VPB(VPWR),
    .VPWR(VPWR),
    .Y(_0296_));
 sky130_fd_sc_hd__or2_1 _0715_ (.A(_0295_),
    .B(_0296_),
    .VGND(VGND),
    .VNB(VGND),
    .VPB(VPWR),
    .VPWR(VPWR),
    .X(_0297_));
 sky130_fd_sc_hd__buf_2 _0716_ (.A(\cpu.decode.co_mem_word ),
    .VGND(VGND),
    .VNB(VGND),
    .VPB(VPWR),
    .VPWR(VPWR),
    .X(_0298_));
 sky130_fd_sc_hd__nor2_1 _0717_ (.A(_0260_),
    .B(_0298_),
    .VGND(VGND),
    .VNB(VGND),
    .VPB(VPWR),
    .VPWR(VPWR),
    .Y(_0299_));
 sky130_fd_sc_hd__buf_2 _0718_ (.A(\cpu.bufreg.i_right_shift_op ),
    .VGND(VGND),
    .VNB(VGND),
    .VPB(VPWR),
    .VPWR(VPWR),
    .X(_0300_));
 sky130_fd_sc_hd__or4_1 _0719_ (.A(net118),
    .B(net119),
    .C(net116),
    .D(net117),
    .VGND(VGND),
    .VNB(VGND),
    .VPB(VPWR),
    .VPWR(VPWR),
    .X(_0301_));
 sky130_fd_sc_hd__nor2_1 _0720_ (.A(net120),
    .B(_0301_),
    .VGND(VGND),
    .VNB(VGND),
    .VPB(VPWR),
    .VPWR(VPWR),
    .Y(_0302_));
 sky130_fd_sc_hd__xor2_1 _0721_ (.A(net121),
    .B(_0302_),
    .VGND(VGND),
    .VNB(VGND),
    .VPB(VPWR),
    .VPWR(VPWR),
    .X(_0303_));
 sky130_fd_sc_hd__or2_1 _0722_ (.A(\cpu.state.init_done ),
    .B(\cpu.gen_csr.csr.o_new_irq ),
    .VGND(VGND),
    .VNB(VGND),
    .VPB(VPWR),
    .VPWR(VPWR),
    .X(_0304_));
 sky130_fd_sc_hd__and2b_1 _0723_ (.A_N(\cpu.bufreg.i_right_shift_op ),
    .B(\cpu.decode.co_mem_word ),
    .VGND(VGND),
    .VNB(VGND),
    .VPB(VPWR),
    .VPWR(VPWR),
    .X(_0305_));
 sky130_fd_sc_hd__and2b_1 _0724_ (.A_N(\cpu.decode.co_mem_word ),
    .B(\cpu.bne_or_bge ),
    .VGND(VGND),
    .VNB(VGND),
    .VPB(VPWR),
    .VPWR(VPWR),
    .X(_0306_));
 sky130_fd_sc_hd__inv_2 _0725_ (.A(\cpu.decode.opcode[0] ),
    .VGND(VGND),
    .VNB(VGND),
    .VPB(VPWR),
    .VPWR(VPWR),
    .Y(_0307_));
 sky130_fd_sc_hd__o211ai_1 _0726_ (.A1(_0305_),
    .A2(_0306_),
    .B1(_0259_),
    .C1(_0307_),
    .VGND(VGND),
    .VNB(VGND),
    .VPB(VPWR),
    .VPWR(VPWR),
    .Y(_0308_));
 sky130_fd_sc_hd__inv_2 _0727_ (.A(\cpu.bufreg.i_right_shift_op ),
    .VGND(VGND),
    .VNB(VGND),
    .VPB(VPWR),
    .VPWR(VPWR),
    .Y(_0309_));
 sky130_fd_sc_hd__buf_2 _0728_ (.A(\cpu.state.cnt_r[3] ),
    .VGND(VGND),
    .VNB(VGND),
    .VPB(VPWR),
    .VPWR(VPWR),
    .X(_0310_));
 sky130_fd_sc_hd__clkbuf_4 _0729_ (.A(\cpu.bufreg2.i_bytecnt[1] ),
    .VGND(VGND),
    .VNB(VGND),
    .VPB(VPWR),
    .VPWR(VPWR),
    .X(_0311_));
 sky130_fd_sc_hd__buf_2 _0730_ (.A(\cpu.state.o_cnt[2] ),
    .VGND(VGND),
    .VNB(VGND),
    .VPB(VPWR),
    .VPWR(VPWR),
    .X(_0312_));
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
    .X(_0225_));
 sky130_fd_sc_hd__clkbuf_1 _1287_ (.A(_0225_),
    .VGND(VGND),
    .VNB(VGND),
    .VPB(VPWR),
    .VPWR(VPWR),
    .X(_0156_));
 sky130_fd_sc_hd__mux2_1 _1288_ (.A0(net108),
    .A1(net109),
    .S(_0211_),
    .VGND(VGND),
    .VNB(VGND),
    .VPB(VPWR),
    .VPWR(VPWR),
    .X(_0226_));
 sky130_fd_sc_hd__mux2_1 _1289_ (.A0(_0226_),
    .A1(net10),
    .S(_0590_),
    .VGND(VGND),
    .VNB(VGND),
    .VPB(VPWR),
    .VPWR(VPWR),
    .X(_0227_));
 sky130_fd_sc_hd__clkbuf_1 _1290_ (.A(_0227_),
    .VGND(VGND),
    .VNB(VGND),
    .VPB(VPWR),
    .VPWR(VPWR),
    .X(_0157_));
 sky130_fd_sc_hd__mux2_1 _1291_ (.A0(net109),
    .A1(net110),
    .S(_0211_),
    .VGND(VGND),
    .VNB(VGND),
    .VPB(VPWR),
    .VPWR(VPWR),
    .X(_0228_));
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
