dangthanhson2kk4-dotcom/Openlane_SERV_OPT/runs/Routing/tmp/signoff/25-serv_synth_wrapper.pnl.v

module serv_synth_wrapper (VGND,
    VPWR,
    clk,
    i_dbus_ack,
    i_ibus_ack,
    i_rst,
    i_timer_irq,
    o_dbus_cyc,
    o_dbus_we,
    o_ibus_cyc,
    o_wen,
    i_dbus_rdt,
    i_ibus_rdt,
    i_rdata,
    o_dbus_adr,
    o_dbus_dat,
    o_dbus_sel,
    o_ibus_adr,
    o_raddr,
    o_waddr,
    o_wdata);
 input VGND;
 input VPWR;
 input clk;
 input i_dbus_ack;
 input i_ibus_ack;
 input i_rst;
 input i_timer_irq;
 output o_dbus_cyc;
 output o_dbus_we;
 output o_ibus_cyc;
 output o_wen;
 input [31:0] i_dbus_rdt;
 input [31:0] i_ibus_rdt;
 input [1:0] i_rdata;
 output [31:0] o_dbus_adr;
 output [31:0] o_dbus_dat;
 output [3:0] o_dbus_sel;
 output [31:0] o_ibus_adr;
 output [9:0] o_raddr;
 output [9:0] o_waddr;
 output [1:0] o_wdata;

 wire net194;
 wire net195;
 wire _0000_;
 wire _0001_;
 wire _0002_;
 wire _0003_;
 wire _0004_;
 wire _0005_;
 wire _0006_;
 wire _0007_;
 wire _0008_;
 wire _0009_;
 wire _0010_;
 wire _0011_;
 wire _0012_;
 wire _0013_;
 wire _0014_;
 wire _0015_;
 wire _0016_;
 wire _0017_;
 wire _0018_;
 wire _0019_;
 wire _0020_;
 wire _0021_;
 wire _0022_;
 wire _0023_;
 wire _0024_;
 wire _0025_;
 wire _0026_;
 wire _0027_;
 wire _0028_;
 wire _0029_;
 wire _0030_;
 wire _0031_;
 wire _0032_;
 wire _0033_;
 wire _0034_;
 wire _0035_;
 wire _0036_;
 wire _0037_;
 wire _0038_;
 wire _0039_;
 wire _0040_;
 wire _0041_;
 wire _0042_;
 wire _0043_;
 wire _0044_;
 wire _0045_;
 wire _0046_;
 wire _0047_;
 wire _0048_;
 wire _0049_;
 wire _0050_;
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
    .VGND(VGND),
    .VPB(VPWR),
    .VNB(VGND));
 sky130_ef_sc_hd__decap_12 FILLER_0_43_153 (.VPWR(VPWR),
    .VGND(VGND),
    .VPB(VPWR),
    .VNB(VGND));
 sky130_fd_sc_hd__decap_3 FILLER_0_43_165 (.VGND(VGND),
    .VNB(VGND),
    .VPB(VPWR),
    .VPWR(VPWR));
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
